soldernerd/LevelMeter/Levelmeter_RevB/Levelmeter.kicad_pcb

## KiCad design Levelmeter_RevB/Levelmeter.kicad_pcb (2026-08-13)

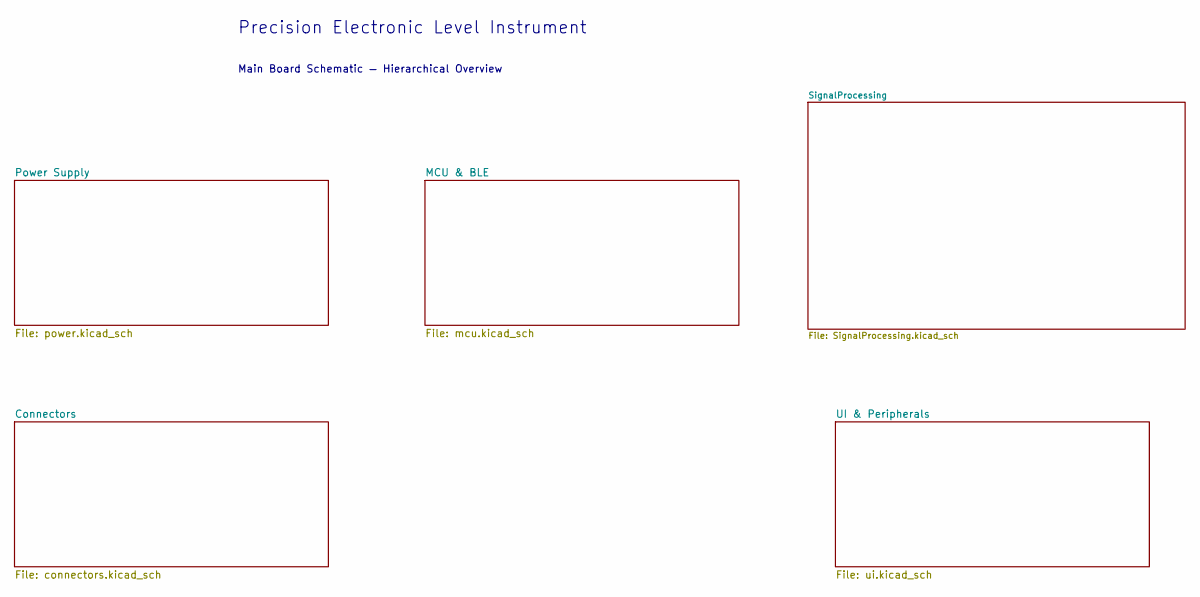
[picture p1: schematic Levelmeter.kicad_sch, Precision Electronic Level Instrument]

Notes on the sheet:
Main Board Schematic — Hierarchical Overview
Precision Electronic Level Instrument

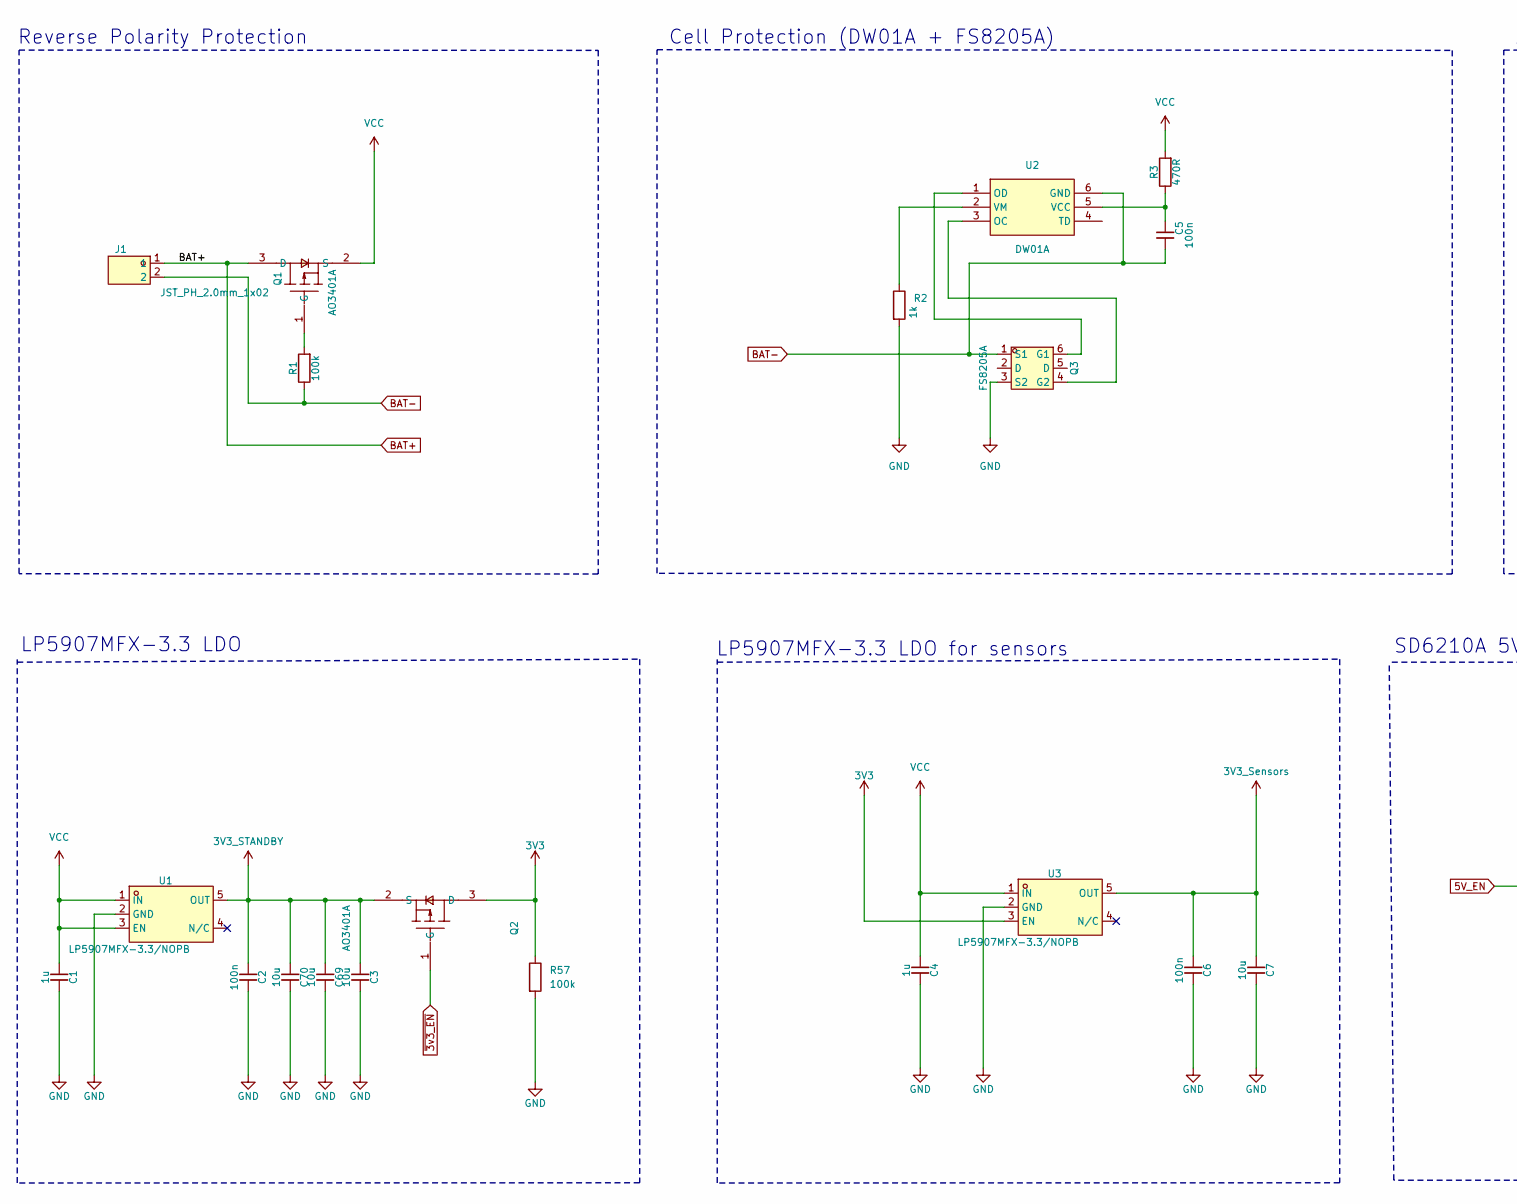
[picture p2: schematic power.kicad_sch, Power Supply, part in row 1, column 1]

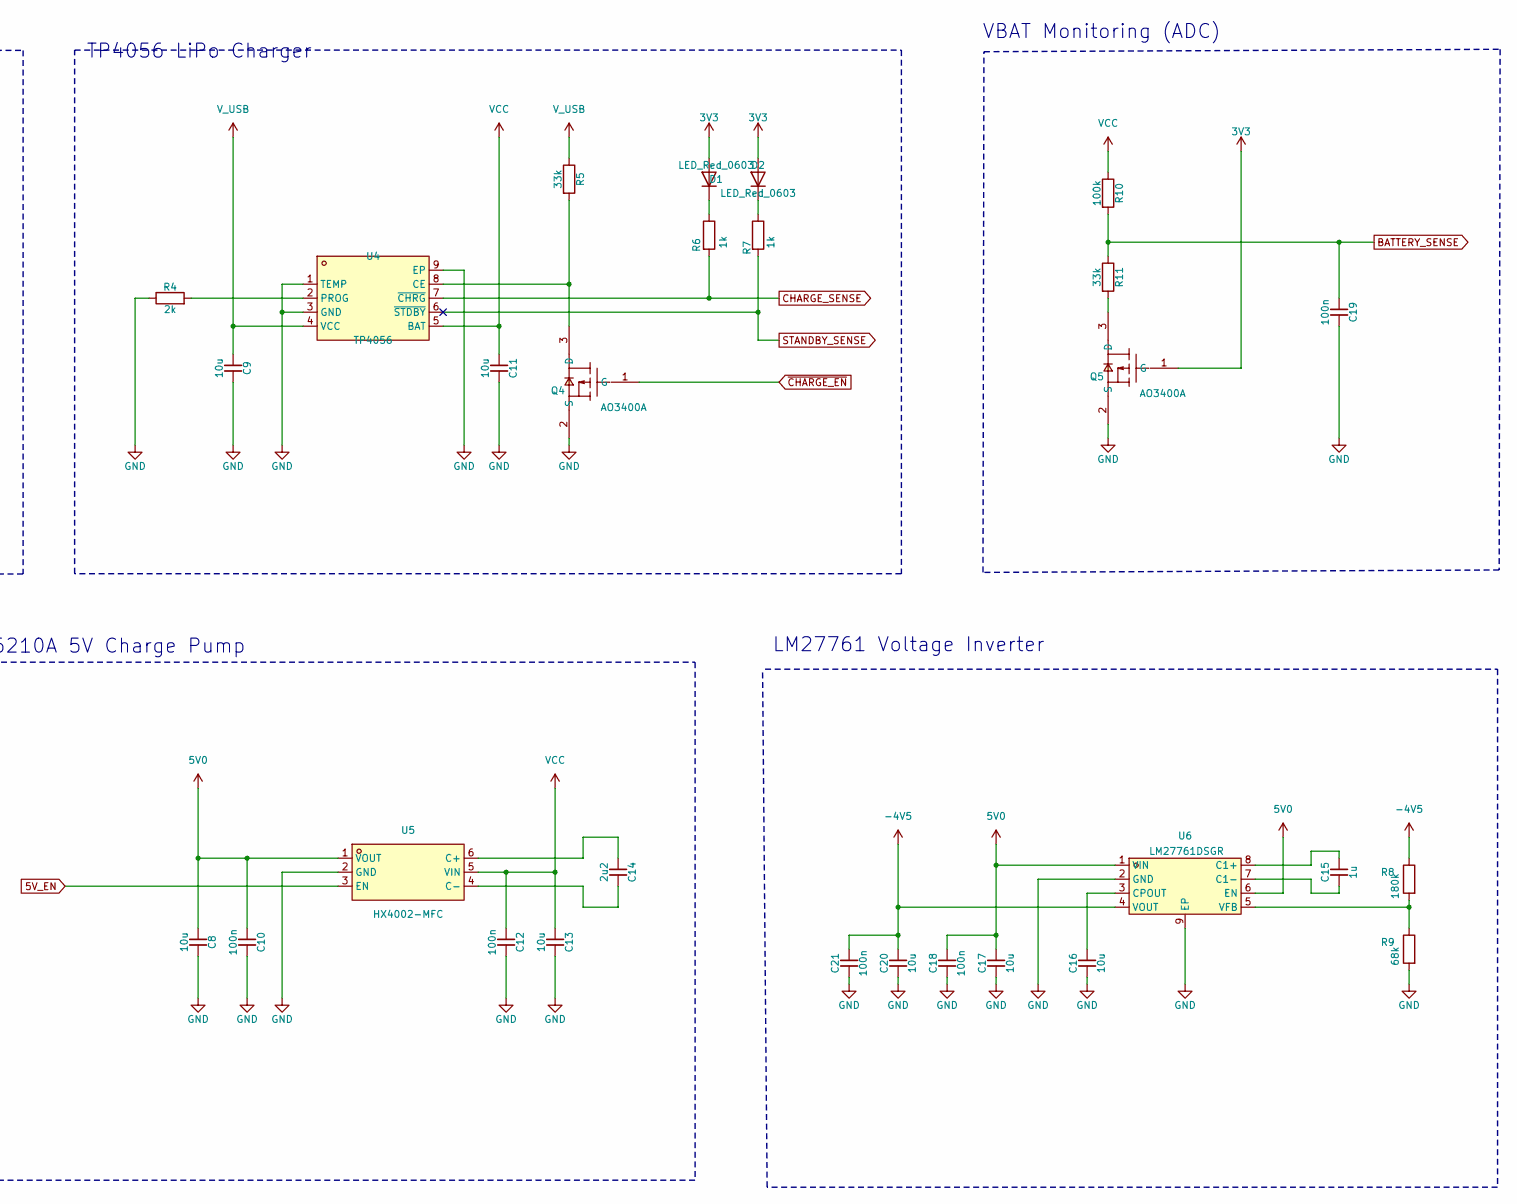
[picture p3: schematic power.kicad_sch, Power Supply, part in row 1, column 2]

Parts:
C1, C4, C15: 1u; C_0805; Voltage 50V; MPN CL21B105KBFNNNE; LCSC C28323
C2, C5, C6, C10, C12, C18, C19, C21: 100n; C_0603; Voltage 50V; MPN CC0603KRX7R9BB104; LCSC C14663
C3, C7, C8, C9, C11, C13, C16, C17, C20, C69, C70: 10u; C_0805; Voltage 50V; MPN GRM21BR61H106KE43L; LCSC C440198
C14: 2u2; C_0805; Voltage 50V; MPN CL21A225KBQNNNE; LCSC C377773
D1, D2: LED_Red_0603; LED_0603; MPN KT-0603R; LCSC C2286
J1: JST_PH_2.0mm_1x02; MPN B2B-PH-K-S; LCSC C131337
Q1, Q2: AO3401A; SOT-23-3; MPN AO3401A; LCSC C15127
Q3: FS8205A; SOT-23-6; MPN FS8205A; LCSC C2830320
Q4, Q5: AO3400A; SOT-23-3; MPN AO3400A; LCSC C20917
R1, R10, R57: 100k; R_0603; MPN 0603WAF1003T5E; LCSC C25803
R2, R6, R7: 1k; R_0603; MPN 0603WAF1001T5E; LCSC C21190
R3: 470R; R_0603; MPN 0603WAF4700T5E; LCSC C23179
R4: 2k; R_0603; MPN 0603WAF2001T5E; LCSC C22975
R5, R11: 33k; R_0603; MPN 0603WAF3302T5E; LCSC C4216
R8: 180k; R_0603; MPN 0603WAF1803T5E; LCSC C22827
R9: 68k; R_0603; MPN 0603WAF6802T5E; LCSC C23231
U1, U3: LP5907MFX-3.3/NOPB; SOT-23-5; MPN LP5907MFX-3.3/NOPB; LCSC C80670
U2: DW01A; SOT-23-6; MPN DW01A; LCSC C351410
U4: TP4056; ESOP-8; MPN TP4056; LCSC C382139
U5: HX4002-MFC; SOT-23-6; MPN HX4002-MFC; LCSC C172354
U6: LM27761DSGR; WSON-8-2x2-EP; MPN LM27761DSGR; LCSC C129351

Connections:
3V3: D1.2 (A), D2.2 (A), Q2.3 (D), Q5.1 (G), R57.1, U3.3 (EN); also elsewhere on the board
3V3_STANDBY: C2.1, C3.1, C69.1, C70.1, Q2.2 (S), U1.5 (OUT); also elsewhere on the board
3V3_Sensors: C6.1, C7.1, U3.5 (OUT); also elsewhere on the board
5V0: C8.1, C10.1, C17.1, C18.1, U5.1 (VOUT), U6.1 (VIN), U6.6 (EN); also elsewhere on the board
5V_EN: U5.3 (EN); also elsewhere on the board
~3v3_EN: Q2.1 (G); also elsewhere on the board
-4V5: C20.1, C21.1, R8.1, U6.4 (VOUT); also elsewhere on the board
BAT+: J1.1, Q1.3 (D)
BAT-: C5.2, J1.2, Q3.1 (S1), R1.1, U2.6 (GND)
BATTERY_SENSE: C19.1, R10.2, R11.1; also elsewhere on the board
CHARGE_SENSE: R6.2, U4.7 (~CHRG); also elsewhere on the board
GND: C1.2, C2.2, C3.2, C4.2, C6.2, C7.2, C8.2, C9.2, C10.2, C11.2, C12.2, C13.2, C16.2, C17.2, C18.2, C19.2, C20.2, C21.2, C69.2, C70.2, Q3.3 (S2), Q4.2 (S), Q5.2 (S), R2.2, R4.1, R9.2, R57.2, U1.2 (GND), U3.2 (GND), U4.1 (TEMP), U4.3 (GND), U4.9 (EP), U5.2 (GND), U6.2 (GND), U6.9 (EP); also elsewhere on the board
unnamed: D1.1 (K), R6.1
unnamed: D2.1 (K), R7.1
unnamed: Q1.1 (G), R1.2
unnamed: Q3.6 (G1), U2.1 (OD)
unnamed: Q3.4 (G2), U2.3 (OC)
unnamed: Q4.3 (D), R5.2, U4.8 (CE)
unnamed: Q5.3 (D), R11.2
unnamed: C5.1, R3.1, U2.5 (VCC)
unnamed: R2.1, U2.2 (VM)
unnamed: R4.2, U4.2 (PROG)
unnamed: C14.1, U5.6 (C+)
unnamed: C14.2, U5.4 (C-)
unnamed: C15.1, U6.8 (C1+)
unnamed: C15.2, U6.7 (C1-)
unnamed: C16.1, U6.3 (CPOUT)
unnamed: R8.2, R9.1, U6.5 (VFB)
STANDBY_SENSE: R7.2, U4.6 (~STDBY); also elsewhere on the board
VCC: C1.1, C4.1, C11.1, C12.1, C13.1, Q1.2 (S), R3.2, R10.1, U1.1 (IN), U1.3 (EN), U3.1 (IN), U4.5 (BAT), U5.5 (VIN)
V_USB: C9.1, R5.1, U4.4 (VCC); also elsewhere on the board
~CHARGE_EN: Q4.1 (G); also elsewhere on the board

Notes on the sheet:
LM27761 Voltage Inverter
LP5907MFX-3.3 LDO
VBAT Monitoring (ADC)
Cell Protection (DW01A + FS8205A)
TP4056 LiPo Charger
Reverse Polarity Protection
SD6210A 5V Charge Pump
LP5907MFX-3.3 LDO for sensors

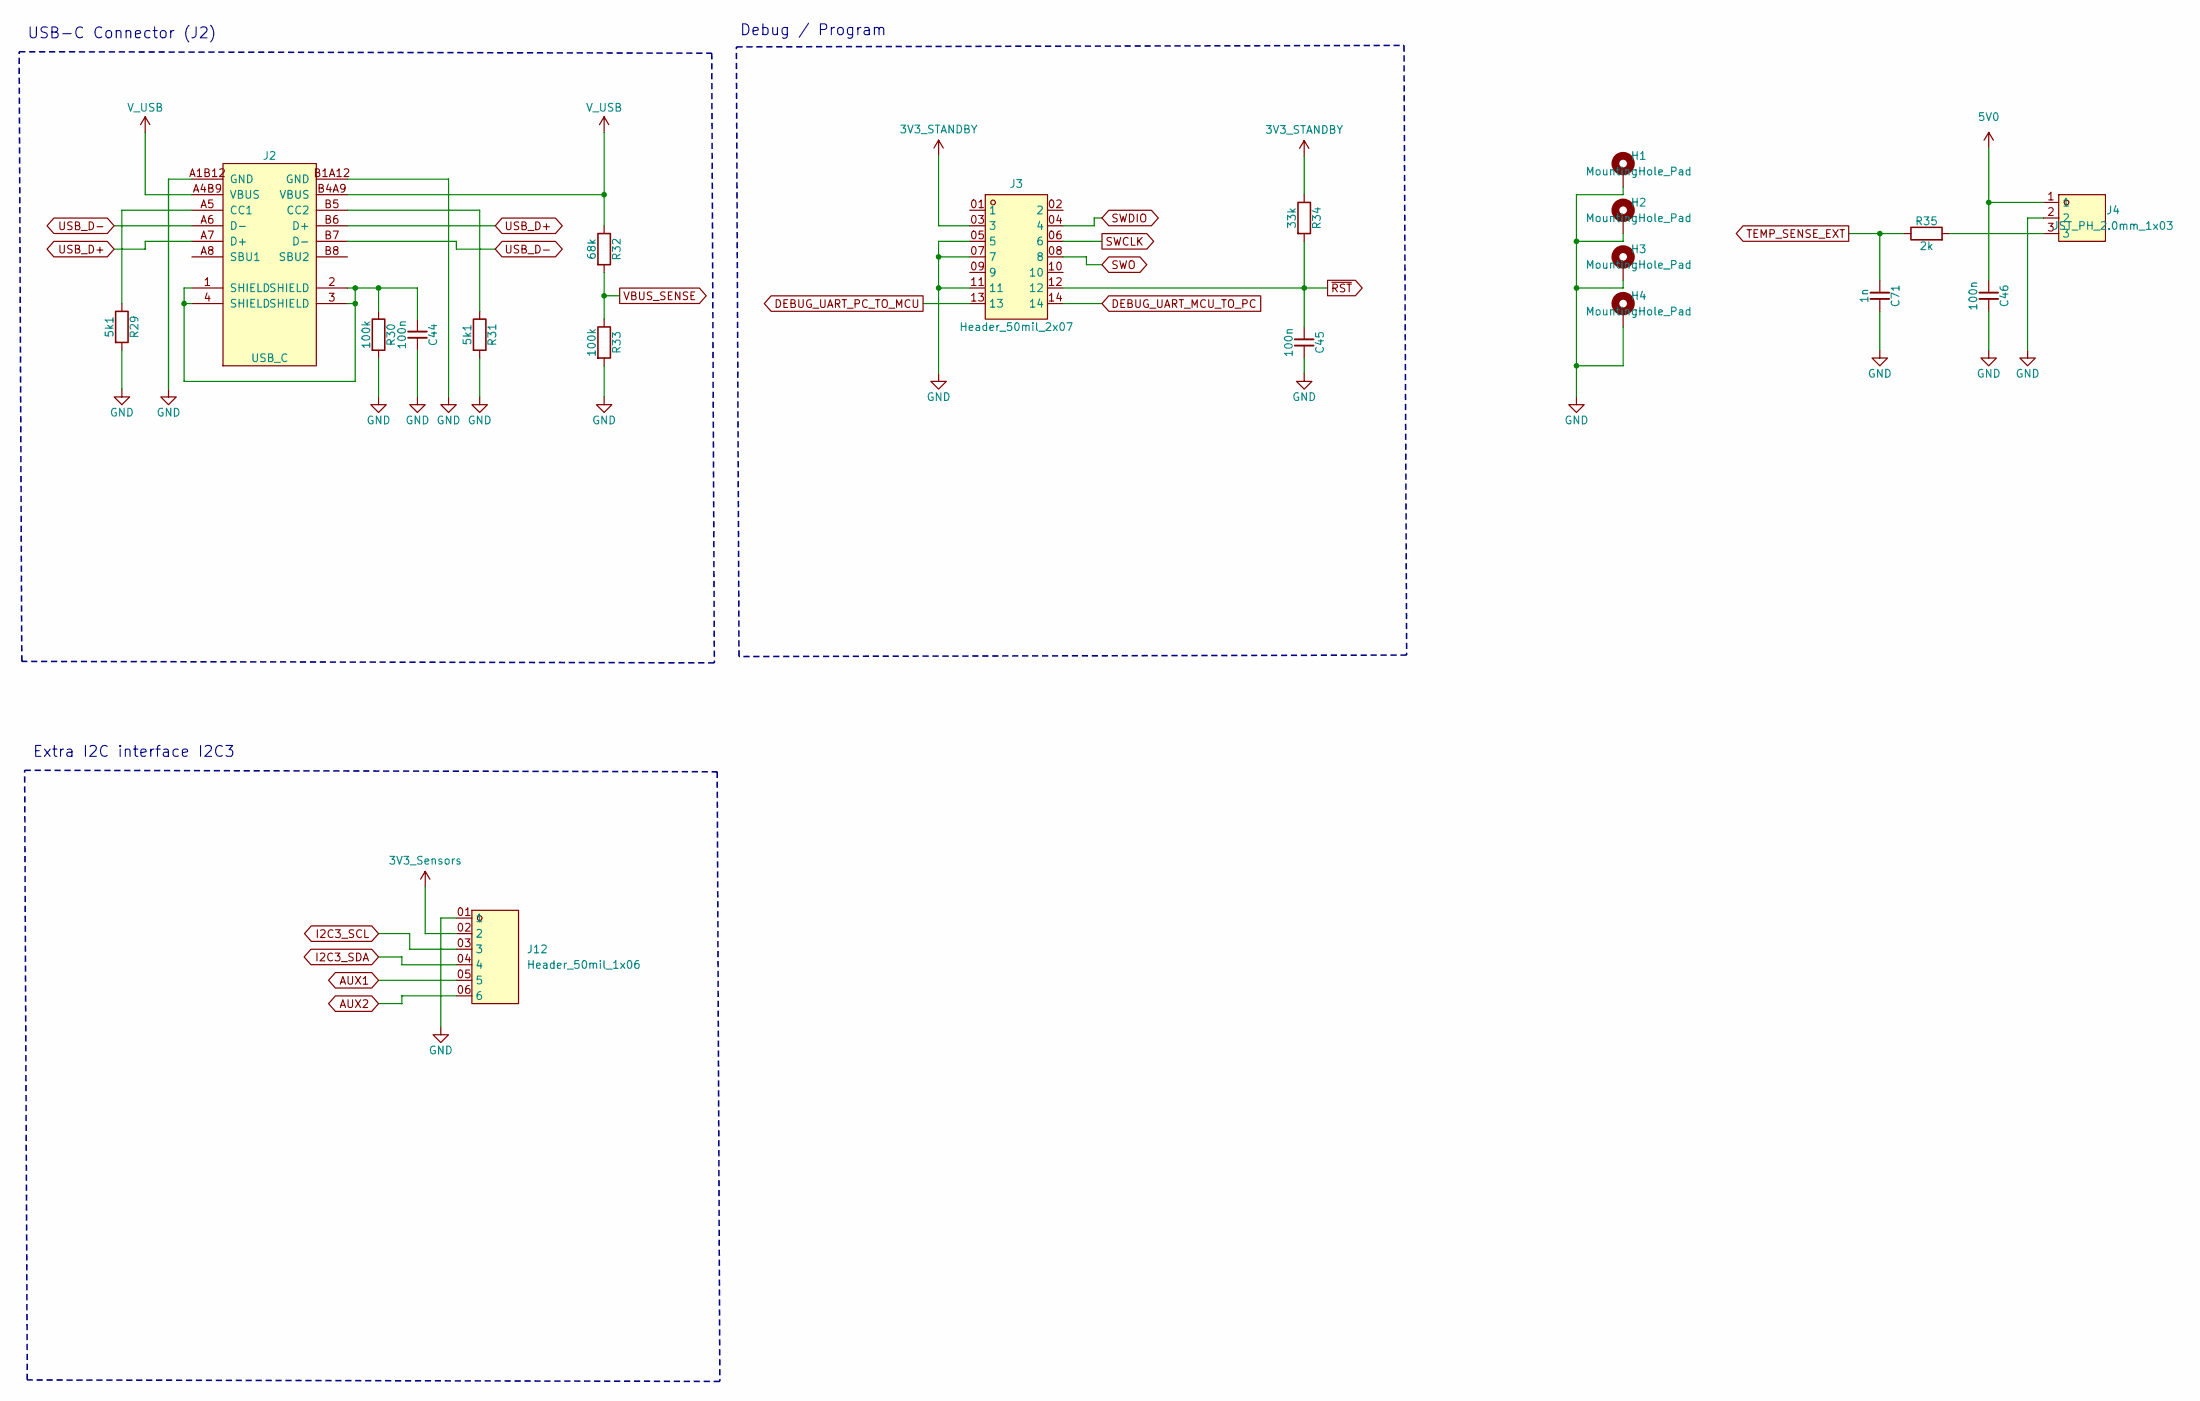
[picture p4: schematic connectors.kicad_sch]

Parts:
C44, C45, C46: 100n; C_0603; Voltage 50V; MPN CC0603KRX7R9BB104; LCSC C14663
C71: 1n; C_0603; Voltage 50V; MPN CL10B102KB8NNNC; LCSC C1588
H1, H2, H3, H4: MountingHole_Pad; MountingHole_3.2mm
J2: USB_C; MPN TYPE-C-31-M-12; LCSC C165948
J3: Header_50mil_2x07; LCSC C5563894
J4: JST_PH_2.0mm_1x03; MPN B3B-PH-K-S; LCSC C131339
J12: Header_50mil_1x06
R29, R31: 5k1; R_0603; MPN 0603WAF5101T5E; LCSC C23186
R30, R33: 100k; R_0603; MPN 0603WAF1003T5E; LCSC C25803
R32: 68k; R_0603; MPN 0603WAF6802T5E; LCSC C23231
R34: 33k; R_0603; MPN 0603WAF3302T5E; LCSC C4216
R35: 2k; R_0603; MPN 0603WAF2001T5E; LCSC C22975

Connections:
3V3_STANDBY: J3.03 (3), R34.1; also elsewhere on the board
3V3_Sensors: J12.02 (2); also elsewhere on the board
5V0: C46.1, J4.1; also elsewhere on the board
AUX1: J12.05 (5); also elsewhere on the board
AUX2: J12.06 (6); also elsewhere on the board
DEBUG_UART_MCU_TO_PC: J3.14; also elsewhere on the board
DEBUG_UART_PC_TO_MCU: J3.13; also elsewhere on the board
GND: C44.2, C45.2, C46.2, C71.2, H1.1 (1_1), H2.1 (1_1), H3.1 (1_1), H4.1 (1_1), J2.A1B12 (GND), J2.B1A12 (GND), J3.05 (5), J3.07 (7), J3.11, J4.2, J12.01 (1), R29.2, R30.2, R31.2, R33.2; also elsewhere on the board
I2C3_SCL: J12.03 (3); also elsewhere on the board
I2C3_SDA: J12.04 (4); also elsewhere on the board
unnamed: C44.1, J2.1 (SHIELD), J2.2 (SHIELD), J2.3 (SHIELD), J2.4 (SHIELD), R30.1
unnamed: J2.A5 (CC1), R29.1
unnamed: J2.B5 (CC2), R31.1
unnamed: J4.3, R35.2
SWCLK: J3.06 (6); also elsewhere on the board
SWDIO: J3.04 (4); also elsewhere on the board
SWO: J3.08 (8); also elsewhere on the board
TEMP_SENSE_EXT: C71.1, R35.1; also elsewhere on the board
USB_D+: J2.A7 (D+), J2.B6 (D+); also elsewhere on the board
USB_D-: J2.A6 (D-), J2.B7 (D-); also elsewhere on the board
VBUS_SENSE: R32.2, R33.1; also elsewhere on the board
V_USB: J2.A4B9 (VBUS), J2.B4A9 (VBUS), R32.1; also elsewhere on the board
~RST: C45.1, J3.12, R34.2; also elsewhere on the board

Notes on the sheet:
Extra I2C interface I2C3
USB-C Connector (J2)
Debug / Program

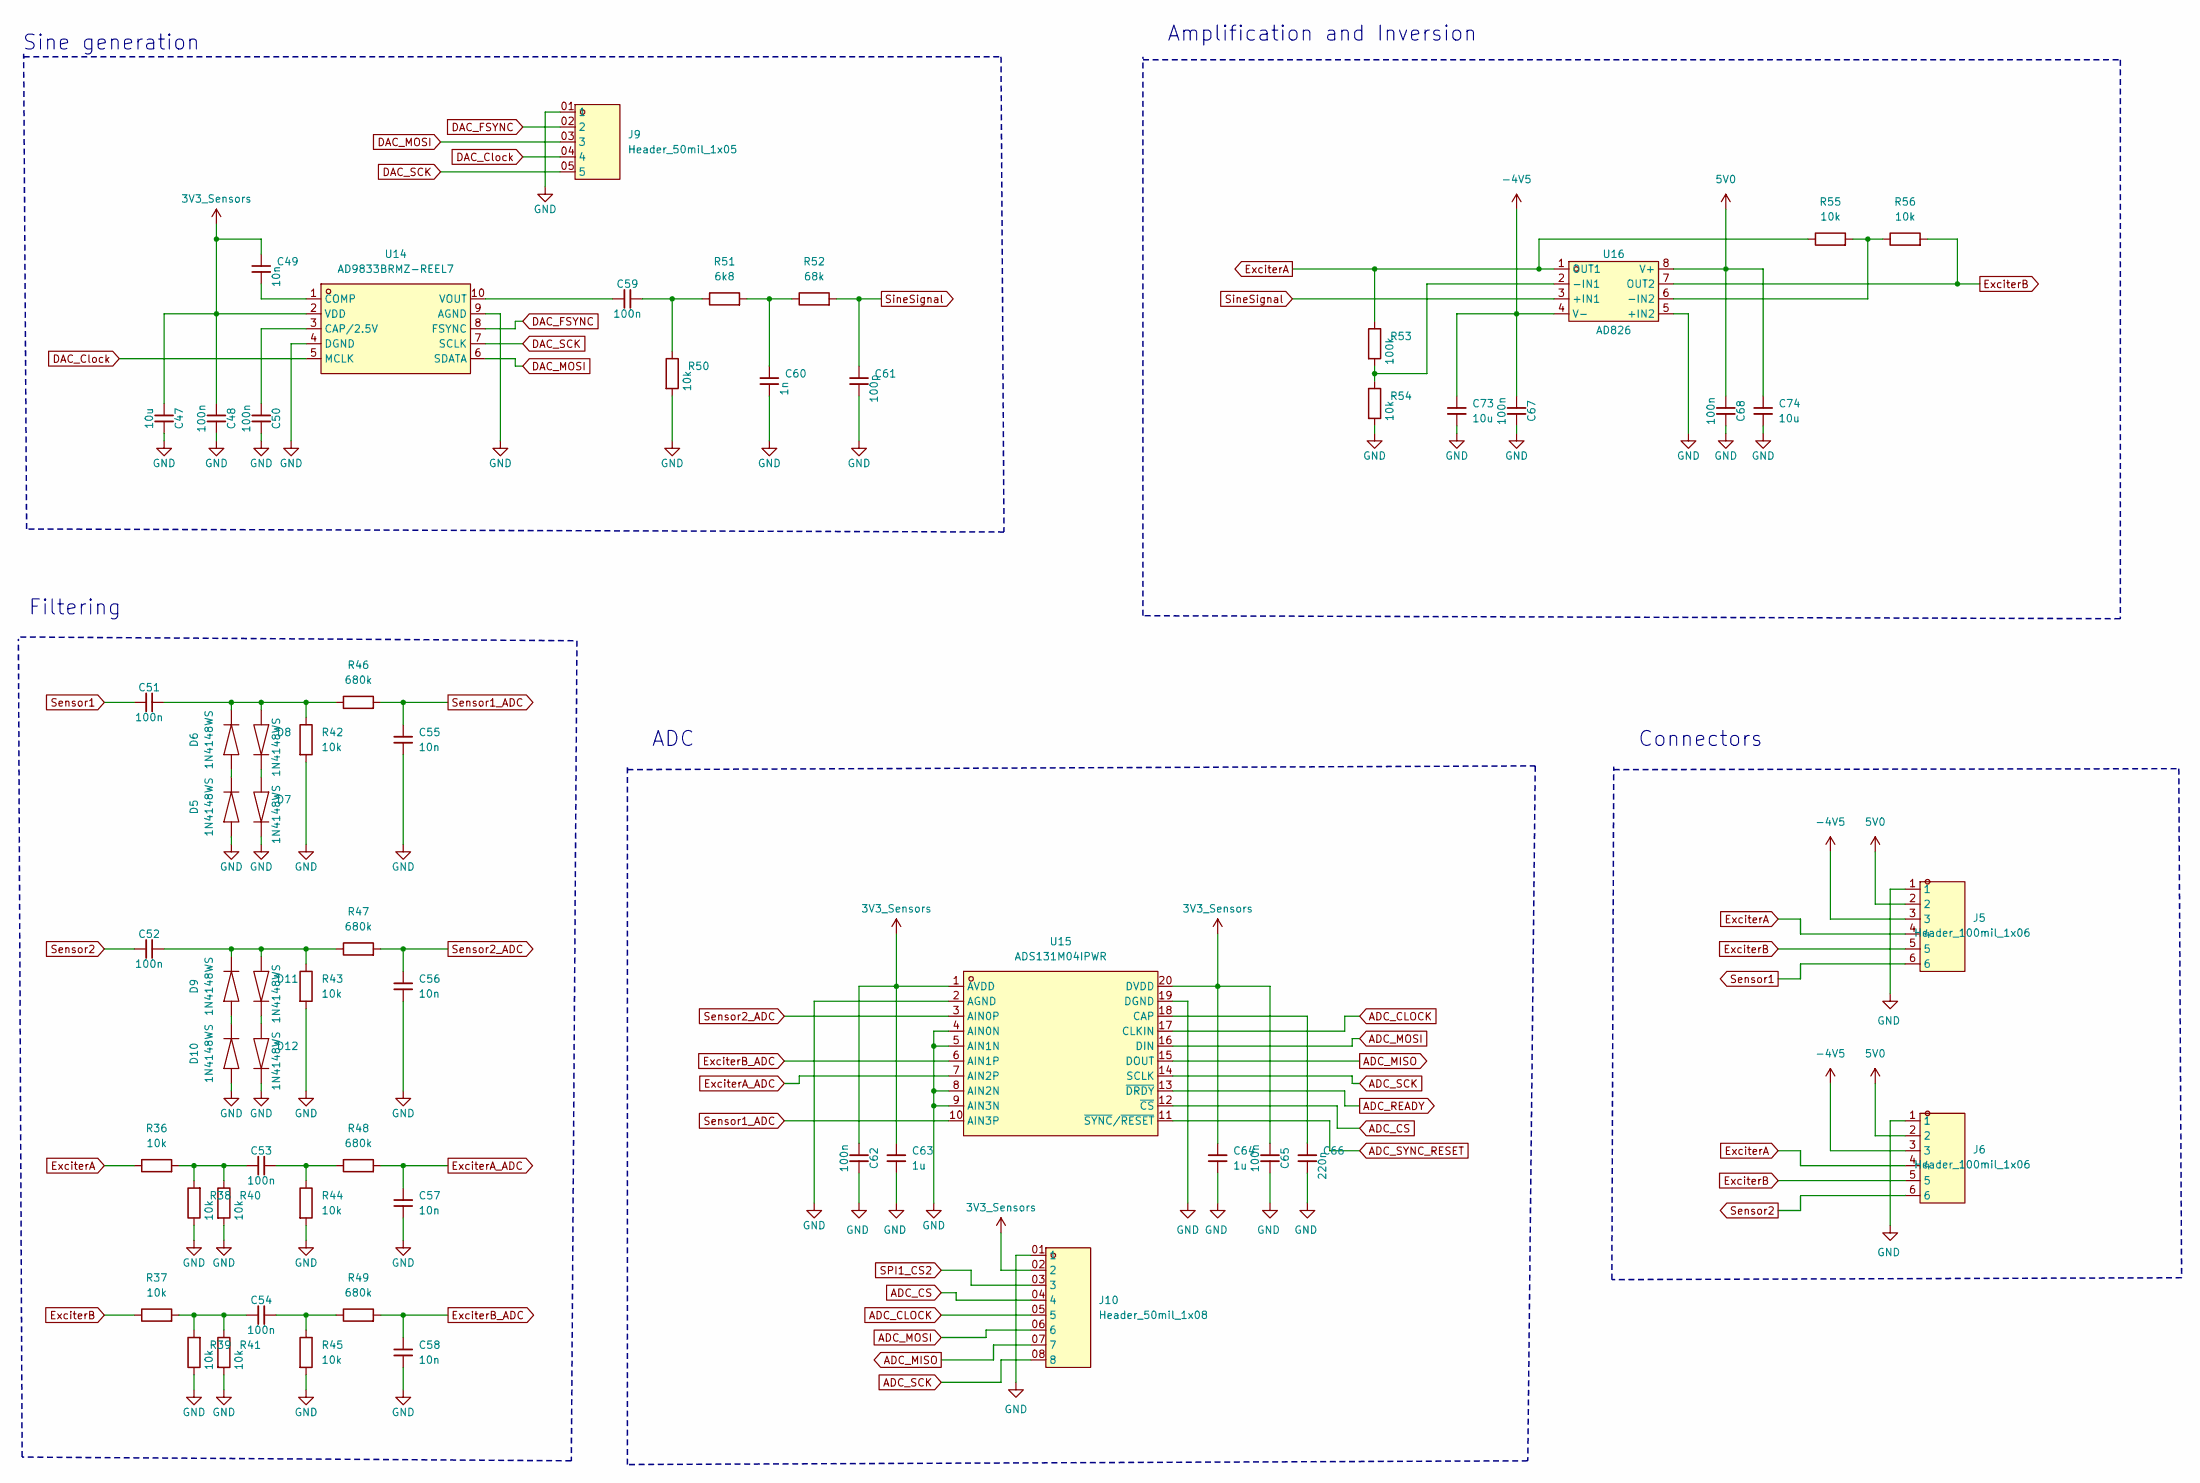
[picture p5: schematic SignalProcessing.kicad_sch]

Parts:
C47, C73, C74: 10u; C_0805; Voltage 50V; MPN GRM21BR61H106KE43L; LCSC C440198
C48, C50, C51, C52, C53, C54, C59, C62, C65, C67, C68: 100n; C_0603; Voltage 50V; MPN CC0603KRX7R9BB104; LCSC C14663
C49, C55, C56, C57, C58: 10n; C_0603; Voltage 50V; MPN 0603B103K500NT; LCSC C57112
C60: 1n; C_0603; Voltage 50V; MPN CL10B102KB8NNNC; LCSC C1588
C61: 100p; C_0603; Voltage 50V; MPN CL10C101JB8NNNC; LCSC C14858
C63, C64: 1u; C_0805; Voltage 50V; MPN CL21B105KBFNNNE; LCSC C28323
C66: 220n; C_0603; Voltage 25V; MPN CL10B224KA8NNNC; LCSC C21120
D5, D6, D7, D8, D9, D10, D11, D12: 1N4148WS; SOD-323; MPN 1N4148WS; LCSC C2128
J5, J6: Header_100mil_1x06; MPN A2541WV-6P; LCSC C225481
J9: Header_50mil_1x05
J10: Header_50mil_1x08
R36, R37, R38, R39, R40, R41, R42, R43, R44, R45, R50, R55, R56: 10k; R_0603; MPN 0603WAF1002T5E; LCSC C25804
R46, R47, R48, R49: 680k; R_0603; MPN 0603WAF6803T5E; LCSC C25822
R51: 6k8; R_0603; MPN 0603WAF6801T5E; LCSC C23212
R52: 68k; R_0603; MPN 0603WAF6802T5E; LCSC C23231
R53: 100k; R_0805; MPN 0805W8F1003T5E; LCSC C149504
R54: 10k; R_0805; MPN 0805W8F1002T5E; LCSC C17414
U14: AD9833BRMZ-REEL7; MSOP-10; MPN AD9833BRMZ-REEL7; LCSC C9652
U15: ADS131M04IPWR; TSSOP-20; MPN ADS131M04IPWR; LCSC C2862562
U16: AD826; SOIC-8; MPN AD826ARZ-REEL7; LCSC C114171

Connections:
3V3_Sensors: C47.1, C48.1, C49.1, C62.1, C63.1, C64.1, C65.1, J10.02 (2), U14.2 (VDD), U15.1 (AVDD), U15.20 (DVDD); also elsewhere on the board
5V0: C68.1, C74.1, J5.2, J6.2, U16.8 (V+); also elsewhere on the board
-4V5: C67.1, C73.1, J5.3, J6.3, U16.4 (V-); also elsewhere on the board
ADC_CLOCK: J10.05 (5), U15.17 (CLKIN); also elsewhere on the board
ADC_CS: J10.04 (4), U15.12 (~CS); also elsewhere on the board
ADC_MISO: J10.07 (7), U15.15 (DOUT); also elsewhere on the board
ADC_MOSI: J10.06 (6), U15.16 (DIN); also elsewhere on the board
ADC_READY: U15.13 (~DRDY); also elsewhere on the board
ADC_SCK: J10.08 (8), U15.14 (SCLK); also elsewhere on the board
ADC_SYNC_RESET: U15.11 (~SYNC/~RESET); also elsewhere on the board
DAC_Clock: J9.04 (4), U14.5 (MCLK); also elsewhere on the board
DAC_FSYNC: J9.02 (2), U14.8 (FSYNC); also elsewhere on the board
DAC_MOSI: J9.03 (3), U14.6 (SDATA); also elsewhere on the board
DAC_SCK: J9.05 (5), U14.7 (SCLK); also elsewhere on the board
ExciterA: J5.4, J6.4, R36.1, R53.1, R55.1, U16.1 (OUT1)
ExciterA_ADC: C57.1, R48.2, U15.7 (AIN2P)
ExciterB: J5.5, J6.5, R37.1, R56.2, U16.7 (OUT2)
ExciterB_ADC: C58.1, R49.2, U15.6 (AIN1P)
GND: C47.2, C48.2, C50.2, C55.2, C56.2, C57.2, C58.2, C60.2, C61.2, C62.2, C63.2, C64.2, C65.2, C66.2, C67.2, C68.2, C73.2, C74.2, D5.2 (A), D7.1 (K), D10.2 (A), D12.1 (K), J5.1, J6.1, J9.01 (1), J10.01 (1), R38.1, R39.1, R40.2, R41.2, R42.2, R43.2, R44.2, R45.2, R50.2, R54.2, U14.4 (DGND), U14.9 (AGND), U15.2 (AGND), U15.4 (AIN0N), U15.5 (AIN1N), U15.8 (AIN2N), U15.9 (AIN3N), U15.19 (DGND), U16.5 (+IN2); also elsewhere on the board
unnamed: C53.1, R36.2, R38.2, R40.1
unnamed: C53.2, R44.1, R48.1
unnamed: C54.1, R37.2, R39.2, R41.1
unnamed: C54.2, R45.1, R49.1
unnamed: C59.2, R50.1, R51.1
unnamed: C60.1, R51.2, R52.1
unnamed: D5.1 (K), D6.2 (A)
unnamed: C51.2, D6.1 (K), D8.2 (A), R42.1, R46.1
unnamed: D7.2 (A), D8.1 (K)
unnamed: D9.2 (A), D10.1 (K)
unnamed: C52.2, D9.1 (K), D11.2 (A), R43.1, R47.1
unnamed: D11.1 (K), D12.2 (A)
unnamed: C50.1, U14.3 (CAP/2.5V)
unnamed: C49.2, U14.1 (COMP)
unnamed: C59.1, U14.10 (VOUT)
unnamed: C66.1, U15.18 (CAP)
unnamed: R53.2, R54.1, U16.2 (-IN1)
unnamed: R55.2, R56.1, U16.6 (-IN2)
SPI1_CS2: J10.03 (3); also elsewhere on the board
Sensor1: C51.1, J5.6
Sensor1_ADC: C55.1, R46.2, U15.10 (AIN3P)
Sensor2: C52.1, J6.6
Sensor2_ADC: C56.1, R47.2, U15.3 (AIN0P)
SineSignal: C61.1, R52.2, U16.3 (+IN1)

Notes on the sheet:
ADC
Connectors
Filtering
Amplification and Inversion
Sine generation

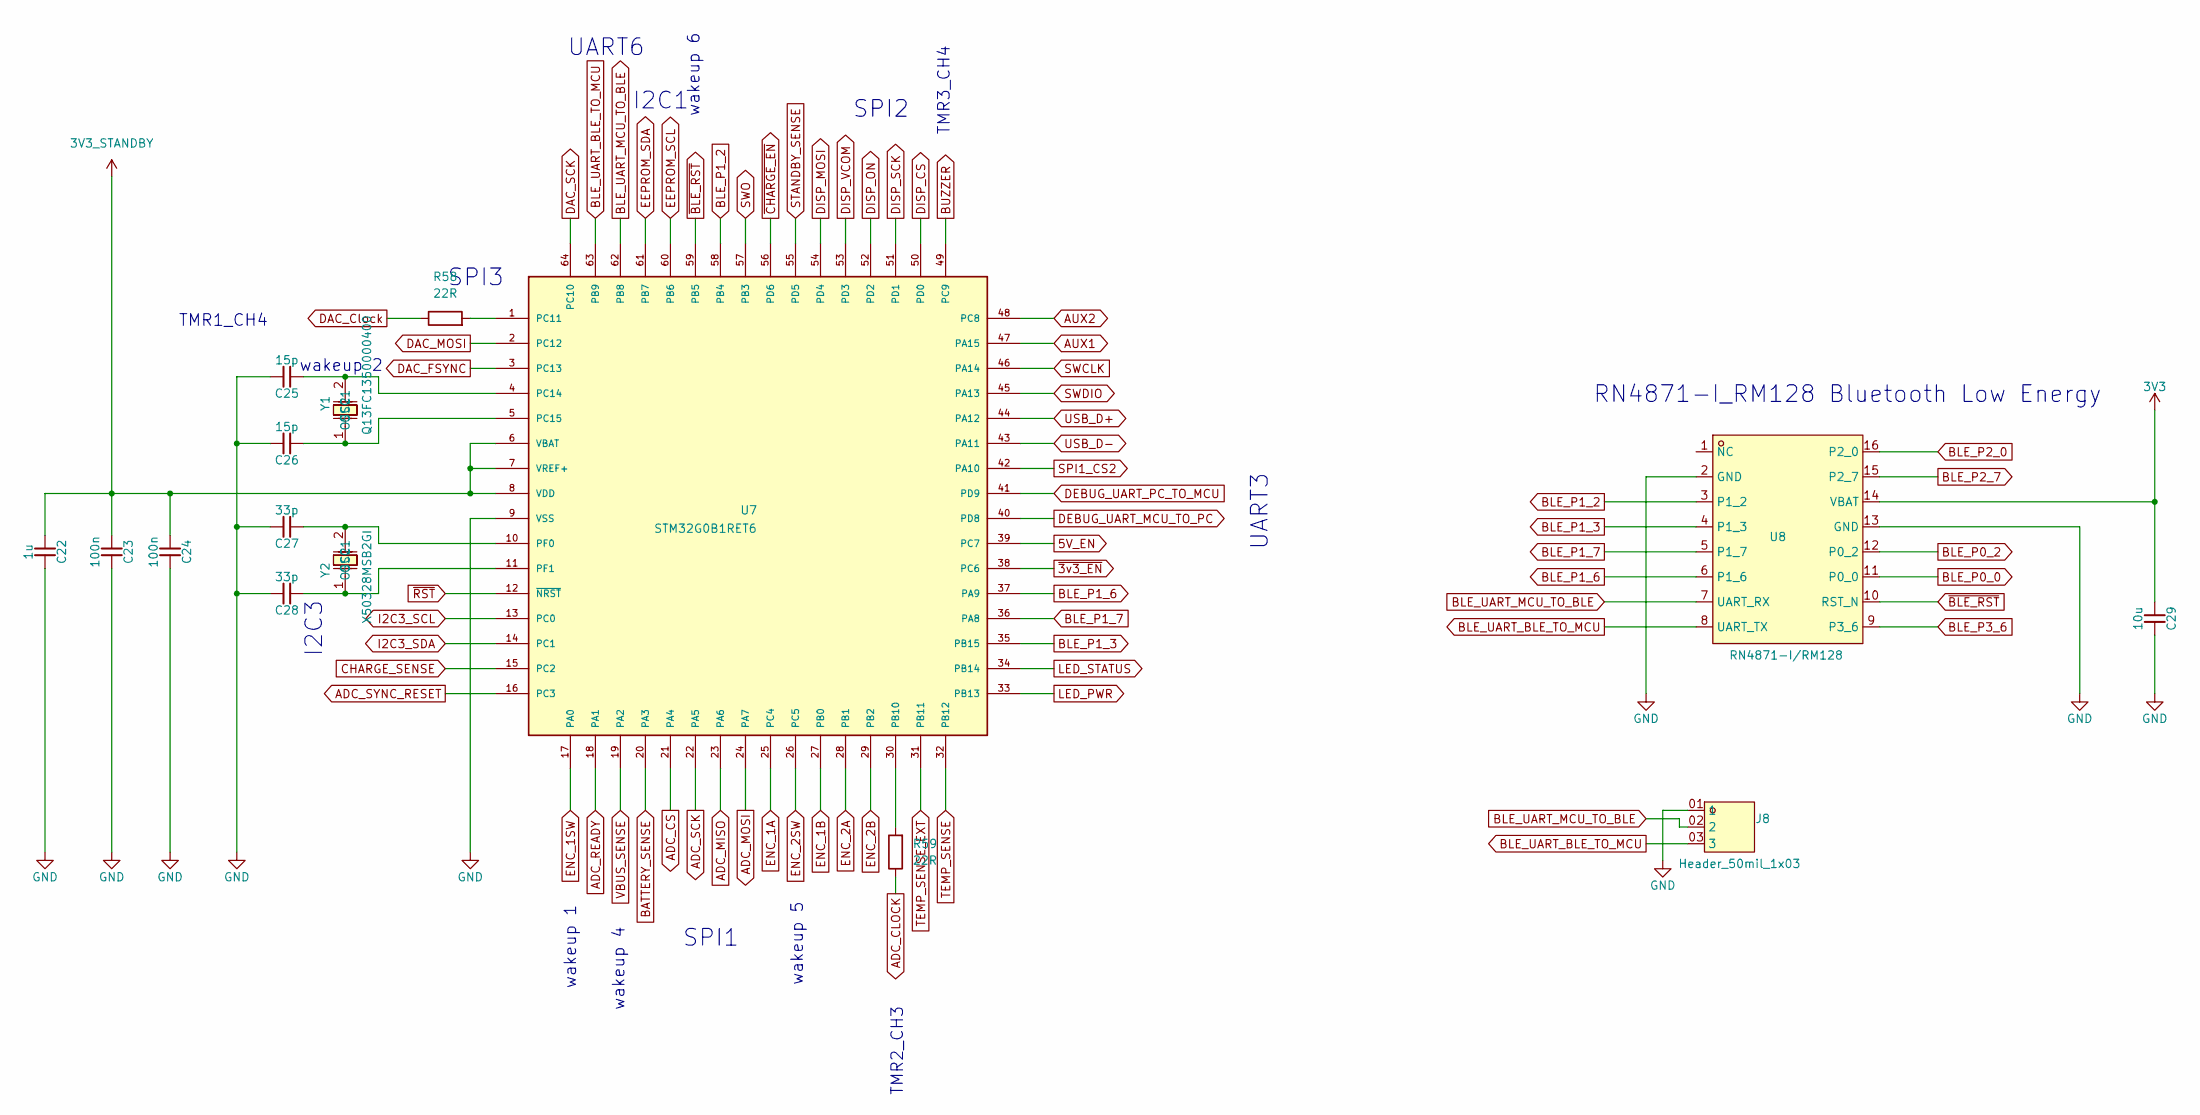
[picture p6: schematic mcu.kicad_sch, Microcontroller — STM32G0B1RET6]

Parts:
C22: 1u; C_0805; Voltage 50V; MPN CL21B105KBFNNNE; LCSC C28323
C23, C24: 100n; C_0603; Voltage 50V; MPN CC0603KRX7R9BB104; LCSC C14663
C25, C26: 15p; C_0603; Voltage 50V; MPN CL10C150JB8NNNC; LCSC C1644
C27, C28: 33p; C_0603; Voltage 50V; MPN CL10C330JB8NNNC; LCSC C1663
C29: 10u; C_0805; Voltage 50V; MPN GRM21BR61H106KE43L; LCSC C440198
J8: Header_50mil_1x03; MPN HC-PZ127-7.2L-1x3PZ; LCSC C42162998
R58, R59: 22R; R_0603; MPN 0603WAF220JT5E; LCSC C23345
U7: STM32G0B1RET6; LQFP-64; LCSC C2829307
U8: RN4871-I/RM128; RN4871; MPN RN4871-I/RM128; LCSC C633941
Y1: Q13FC1350000400; CRYSTAL-3215; MPN Q13FC1350000400; LCSC C32346
Y2: X50328MSB2GI; CRYSTAL-3225; MPN X50328MSB2GI; LCSC C115962

Connections:
3V3: C29.1, U8.14 (VBAT); also elsewhere on the board
3V3_STANDBY: C22.1, C23.1, C24.1, U7.6 (VBAT), U7.7 (VREF+), U7.8 (VDD); also elsewhere on the board
5V_EN: U7.39 (PC7); also elsewhere on the board
~3v3_EN: U7.38 (PC6); also elsewhere on the board
ADC_CLOCK: R59.1; also elsewhere on the board
ADC_CS: U7.21 (PA4); also elsewhere on the board
ADC_MISO: U7.23 (PA6); also elsewhere on the board
ADC_MOSI: U7.24 (PA7); also elsewhere on the board
ADC_READY: U7.18 (PA1); also elsewhere on the board
ADC_SCK: U7.22 (PA5); also elsewhere on the board
ADC_SYNC_RESET: U7.16 (PC3); also elsewhere on the board
AUX1: U7.47 (PA15); also elsewhere on the board
AUX2: U7.48 (PC8); also elsewhere on the board
BATTERY_SENSE: U7.20 (PA3); also elsewhere on the board
BLE_P0_0: U8.11 (P0_0)
BLE_P0_2: U8.12 (P0_2)
BLE_P1_2: U7.58 (PB4), U8.3 (P1_2)
BLE_P1_3: U7.35 (PB15), U8.4 (P1_3)
BLE_P1_6: U7.37 (PA9), U8.6 (P1_6)
BLE_P1_7: U7.36 (PA8), U8.5 (P1_7)
BLE_P2_0: U8.16 (P2_0)
BLE_P2_7: U8.15 (P2_7)
BLE_P3_6: U8.9 (P3_6)
BLE_UART_BLE_TO_MCU: J8.03 (3), U7.63 (PB9), U8.8 (UART_TX)
BLE_UART_MCU_TO_BLE: J8.02 (2), U7.62 (PB8), U8.7 (UART_RX)
BUZZER: U7.49 (PC9); also elsewhere on the board
CHARGE_SENSE: U7.15 (PC2); also elsewhere on the board
DAC_Clock: R58.1; also elsewhere on the board
DAC_FSYNC: U7.3 (PC13); also elsewhere on the board
DAC_MOSI: U7.2 (PC12); also elsewhere on the board
DAC_SCK: U7.64 (PC10); also elsewhere on the board
DEBUG_UART_MCU_TO_PC: U7.40 (PD8); also elsewhere on the board
DEBUG_UART_PC_TO_MCU: U7.41 (PD9); also elsewhere on the board
DISP_CS: U7.50 (PD0); also elsewhere on the board
DISP_MOSI: U7.54 (PD4); also elsewhere on the board
DISP_ON: U7.52 (PD2); also elsewhere on the board
DISP_SCK: U7.51 (PD1); also elsewhere on the board
DISP_VCOM: U7.53 (PD3); also elsewhere on the board
EEPROM_SCL: U7.60 (PB6); also elsewhere on the board
EEPROM_SDA: U7.61 (PB7); also elsewhere on the board
ENC_1A: U7.25 (PC4); also elsewhere on the board
ENC_1B: U7.27 (PB0); also elsewhere on the board
ENC_1SW: U7.17 (PA0); also elsewhere on the board
ENC_2A: U7.28 (PB1); also elsewhere on the board
ENC_2B: U7.29 (PB2); also elsewhere on the board
ENC_2SW: U7.26 (PC5); also elsewhere on the board
GND: C22.2, C23.2, C24.2, C25.2, C26.2, C27.2, C28.2, C29.2, J8.01 (1), U7.9 (VSS), U8.2 (GND), U8.13 (GND); also elsewhere on the board
I2C3_SCL: U7.13 (PC0); also elsewhere on the board
I2C3_SDA: U7.14 (PC1); also elsewhere on the board
LED_PWR: U7.33 (PB13); also elsewhere on the board
LED_STATUS: U7.34 (PB14); also elsewhere on the board
unnamed: R59.2, U7.30 (PB10)
unnamed: R58.2, U7.1 (PC11)
unnamed: C25.1, U7.4 (PC14), Y1.2 (OSC2)
unnamed: C26.1, U7.5 (PC15), Y1.1 (OSC1)
unnamed: C27.1, U7.10 (PF0), Y2.2 (OSC2)
unnamed: C28.1, U7.11 (PF1), Y2.1 (OSC1)
SPI1_CS2: U7.42 (PA10); also elsewhere on the board
STANDBY_SENSE: U7.55 (PD5); also elsewhere on the board
SWCLK: U7.46 (PA14); also elsewhere on the board
SWDIO: U7.45 (PA13); also elsewhere on the board
SWO: U7.57 (PB3); also elsewhere on the board
TEMP_SENSE: U7.32 (PB12); also elsewhere on the board
TEMP_SENSE_EXT: U7.31 (PB11); also elsewhere on the board
USB_D+: U7.44 (PA12); also elsewhere on the board
USB_D-: U7.43 (PA11); also elsewhere on the board
VBUS_SENSE: U7.19 (PA2); also elsewhere on the board
~BLE_RST: U7.59 (PB5), U8.10 (RST_N)
~CHARGE_EN: U7.56 (PD6); also elsewhere on the board
~RST: U7.12 (~NRST); also elsewhere on the board

Notes on the sheet:
SPI1
TMR2_CH3
wakeup 2
wakeup 1
TMR3_CH4
TMR1_CH4
SPI2
wakeup 5
I2C3
wakeup 4
I2C1
UART6
wakeup 6
RN4871-I_RM128 Bluetooth Low Energy
UART3
SPI3
