soldernerd/LevelMeter/Levelmeter_RevB/Levelmeter.kicad_pcb

## KiCad design Levelmeter_RevB/Levelmeter.kicad_pcb (continued)

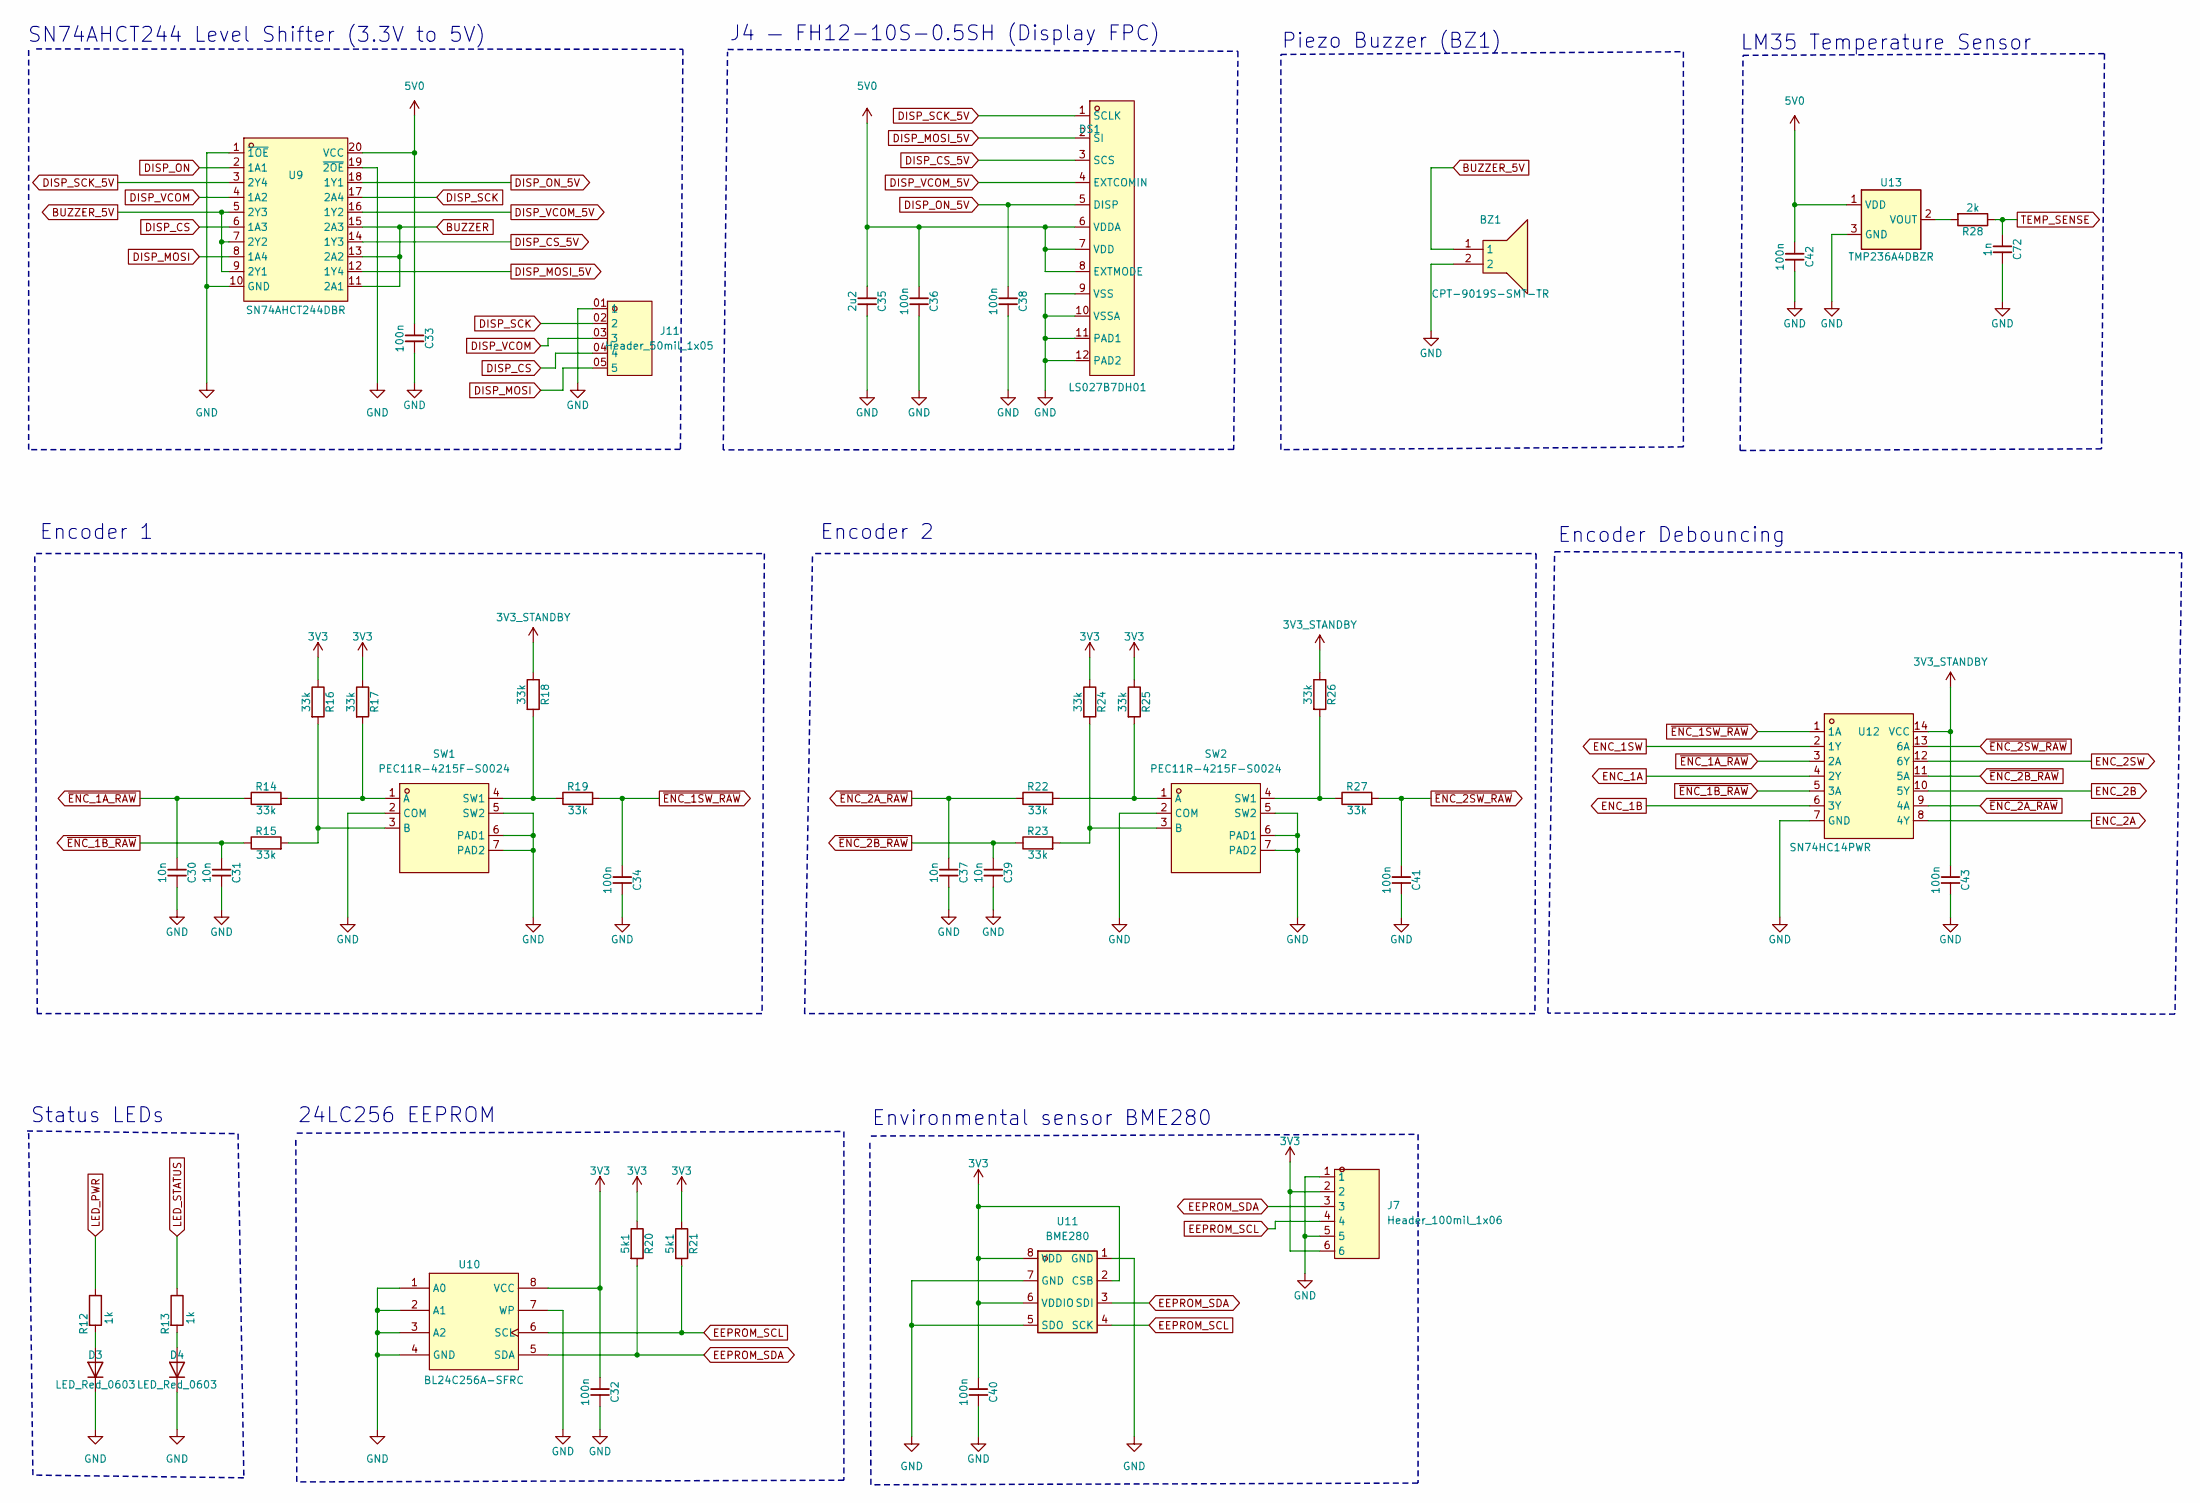
[picture p7: schematic ui.kicad_sch, User Interface & Peripherals]

Parts:
BZ1: CPT-9019S-SMT-TR; CPT-9019S; MPN CPT-9019S-SMT-TR; LCSC C95163
C30, C31, C37, C39: 10n; C_0603; Voltage 50V; MPN 0603B103K500NT; LCSC C57112
C32, C33, C34, C36, C38, C40, C41, C42, C43: 100n; C_0603; Voltage 50V; MPN CC0603KRX7R9BB104; LCSC C14663
C35: 2u2; C_0805; Voltage 50V; MPN CL21A225KBQNNNE; LCSC C377773
C72: 1n; C_0603; Voltage 50V; MPN CL10B102KB8NNNC; LCSC C1588
D3, D4: LED_Red_0603; LED_0603; MPN KT-0603R; LCSC C2286
DS1: LS027B7DH01; Display_LS027B7DH01; MPN LS027B7DH01; LCSC Display: C17492463, Connector: C262557
J7: Header_100mil_1x06; MPN A2541WV-6P; LCSC C225481
J11: Header_50mil_1x05
R12, R13: 1k; R_0603; MPN 0603WAF1001T5E; LCSC C21190
R14, R15, R16, R17, R18, R19, R22, R23, R24, R25, R26, R27: 33k; R_0603; MPN 0603WAF3302T5E; LCSC C4216
R20, R21: 5k1; R_0603; MPN 0603WAF5101T5E; LCSC C23186
R28: 2k; R_0603; MPN 0603WAF2001T5E; LCSC C22975
SW1, SW2: PEC11R-4215F-S0024; RotaryEncoder_PEC11R; MPN PEC11R-4215F-S0024; LCSC C143790
U9: SN74AHCT244DBR; SSOP-20; MPN SN74AHCT244DBR; LCSC C2868870
U10: BL24C256A-SFRC; TSSOP-8; MPN BL24C256A-SFRC; LCSC C110276
U11: BME280; LGA-8_2.5x2.5mm_P0.65mm; MPN BME280; LCSC C92489
U12: SN74HC14PWR; TSSOP-14; MPN SN74HC14PWR; LCSC C6821
U13: TMP236A4DBZR; SOT-23-3; MPN TMP236A4DBZR; LCSC C2872164

Connections:
3V3: C32.1, C40.1, J7.2, J7.6, R16.1, R17.1, R20.1, R21.1, R24.1, R25.1, U10.8 (VCC), U11.2 (CSB), U11.6 (VDDIO), U11.8 (VDD); also elsewhere on the board
3V3_STANDBY: C43.1, R18.1, R26.1, U12.14 (VCC); also elsewhere on the board
5V0: C33.1, C35.1, C36.1, C42.1, DS1.6 (VDDA), DS1.7 (VDD), DS1.8 (EXTMODE), U9.20 (VCC), U13.1 (VDD); also elsewhere on the board
BUZZER: U9.11 (2A1), U9.13 (2A2), U9.15 (2A3); also elsewhere on the board
BUZZER_5V: BZ1.1, U9.5 (2Y3), U9.7 (2Y2), U9.9 (2Y1)
DISP_CS: J11.04 (4), U9.6 (1A3); also elsewhere on the board
DISP_CS_5V: DS1.3 (SCS), U9.14 (1Y3)
DISP_MOSI: J11.05 (5), U9.8 (1A4); also elsewhere on the board
DISP_MOSI_5V: DS1.2 (SI), U9.12 (1Y4)
DISP_ON: U9.2 (1A1); also elsewhere on the board
DISP_ON_5V: C38.1, DS1.5 (DISP), U9.18 (1Y1)
DISP_SCK: J11.02 (2), U9.17 (2A4); also elsewhere on the board
DISP_SCK_5V: DS1.1 (SCLK), U9.3 (2Y4)
DISP_VCOM: J11.03 (3), U9.4 (1A2); also elsewhere on the board
DISP_VCOM_5V: DS1.4 (EXTCOMIN), U9.16 (1Y2)
EEPROM_SCL: J7.4, R21.2, U10.6 (SCL), U11.4 (SCK); also elsewhere on the board
EEPROM_SDA: J7.3, R20.2, U10.5 (SDA), U11.3 (SDI); also elsewhere on the board
ENC_1A: U12.4 (2Y); also elsewhere on the board
ENC_1B: U12.6 (3Y); also elsewhere on the board
ENC_1SW: U12.2 (1Y); also elsewhere on the board
ENC_2A: U12.8 (4Y); also elsewhere on the board
ENC_2B: U12.10 (5Y); also elsewhere on the board
ENC_2SW: U12.12 (6Y); also elsewhere on the board
GND: BZ1.2, C30.2, C31.2, C32.2, C33.2, C34.2, C35.2, C36.2, C37.2, C38.2, C39.2, C40.2, C41.2, C42.2, C43.2, C72.2, D3.1 (K), D4.1 (K), DS1.9 (VSS), DS1.10 (VSSA), DS1.11 (PAD1), DS1.12 (PAD2), J7.1, J7.5, J11.01 (1), SW1.2 (COM), SW1.5 (SW2), SW1.6 (PAD1), SW1.7 (PAD2), SW2.2 (COM), SW2.5 (SW2), SW2.6 (PAD1), SW2.7 (PAD2), U9.1 (~1OE), U9.10 (GND), U9.19 (~2OE), U10.1 (A0), U10.2 (A1), U10.3 (A2), U10.4 (GND), U10.7 (WP), U11.1 (GND), U11.5 (SDO), U11.7 (GND), U12.7 (GND), U13.3 (GND); also elsewhere on the board
LED_PWR: R12.1; also elsewhere on the board
LED_STATUS: R13.1; also elsewhere on the board
unnamed: D3.2 (A), R12.2
unnamed: D4.2 (A), R13.2
unnamed: R14.2, R17.2, SW1.1 (A)
unnamed: R15.2, R16.2, SW1.3 (B)
unnamed: R18.2, R19.1, SW1.4 (SW1)
unnamed: R22.2, R25.2, SW2.1 (A)
unnamed: R23.2, R24.2, SW2.3 (B)
unnamed: R26.2, R27.1, SW2.4 (SW1)
unnamed: R28.2, U13.2 (VOUT)
TEMP_SENSE: C72.1, R28.1; also elsewhere on the board
~ENC_1A_RAW: C30.1, R14.1, U12.3 (2A)
~ENC_1B_RAW: C31.1, R15.1, U12.5 (3A)
~ENC_1SW_RAW: C34.1, R19.2, U12.1 (1A)
~ENC_2A_RAW: C37.1, R22.1, U12.9 (4A)
~ENC_2B_RAW: C39.1, R23.1, U12.11 (5A)
~ENC_2SW_RAW: C41.1, R27.2, U12.13 (6A)

Notes on the sheet:
Encoder 2
Encoder Debouncing
Status LEDs
LM35 Temperature Sensor
SN74AHCT244 Level Shifter (3.3V to 5V)
Environmental sensor BME280
24LC256 EEPROM
J4 — FH12-10S-0.5SH (Display FPC)
Piezo Buzzer (BZ1)
Encoder 1

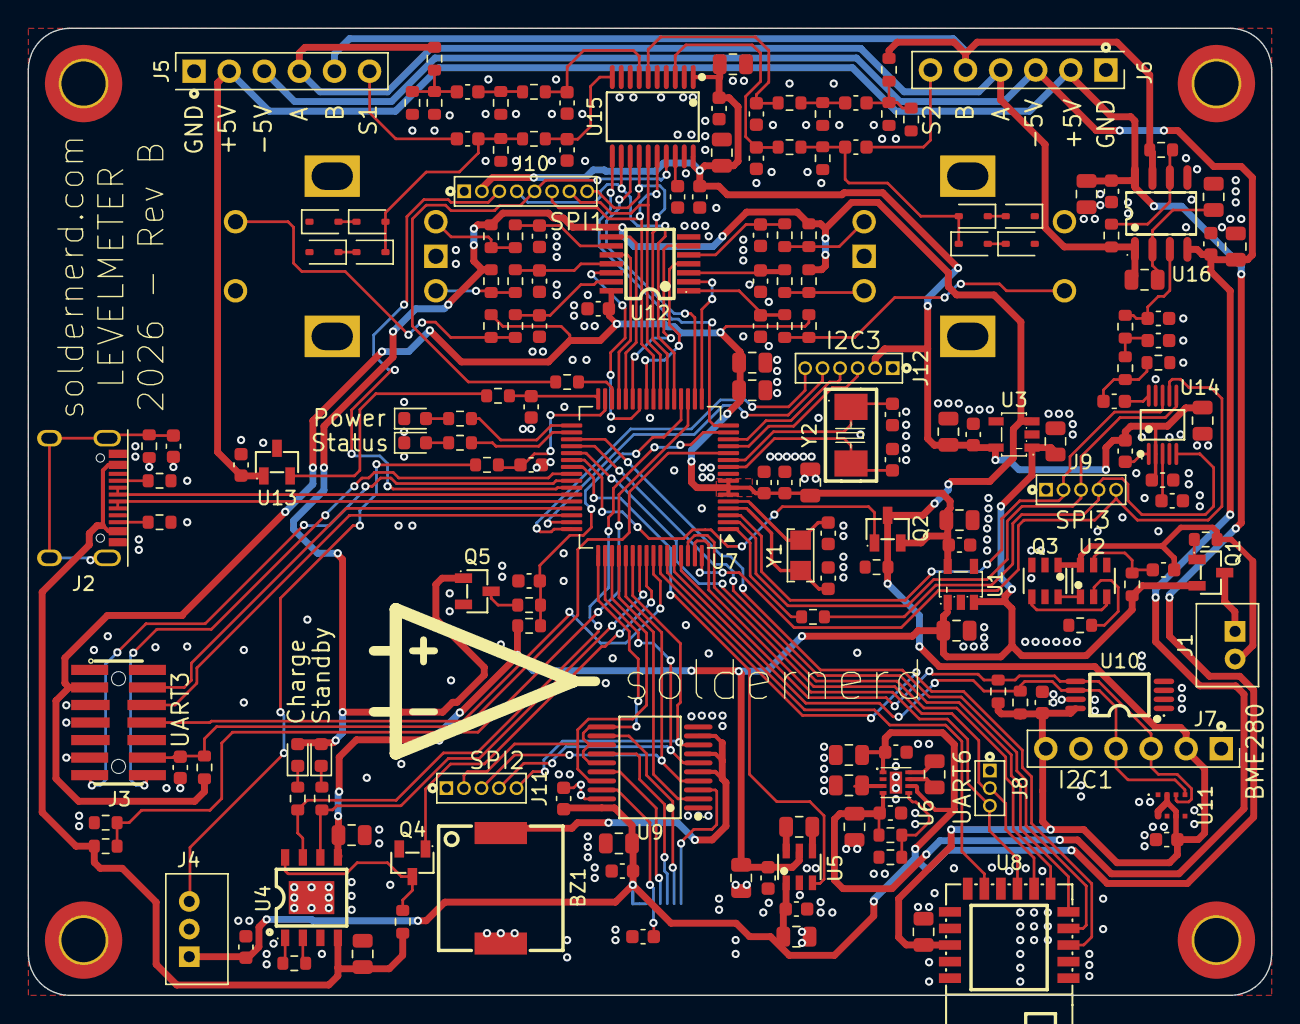
[picture p8: board Levelmeter.kicad_pcb from above]

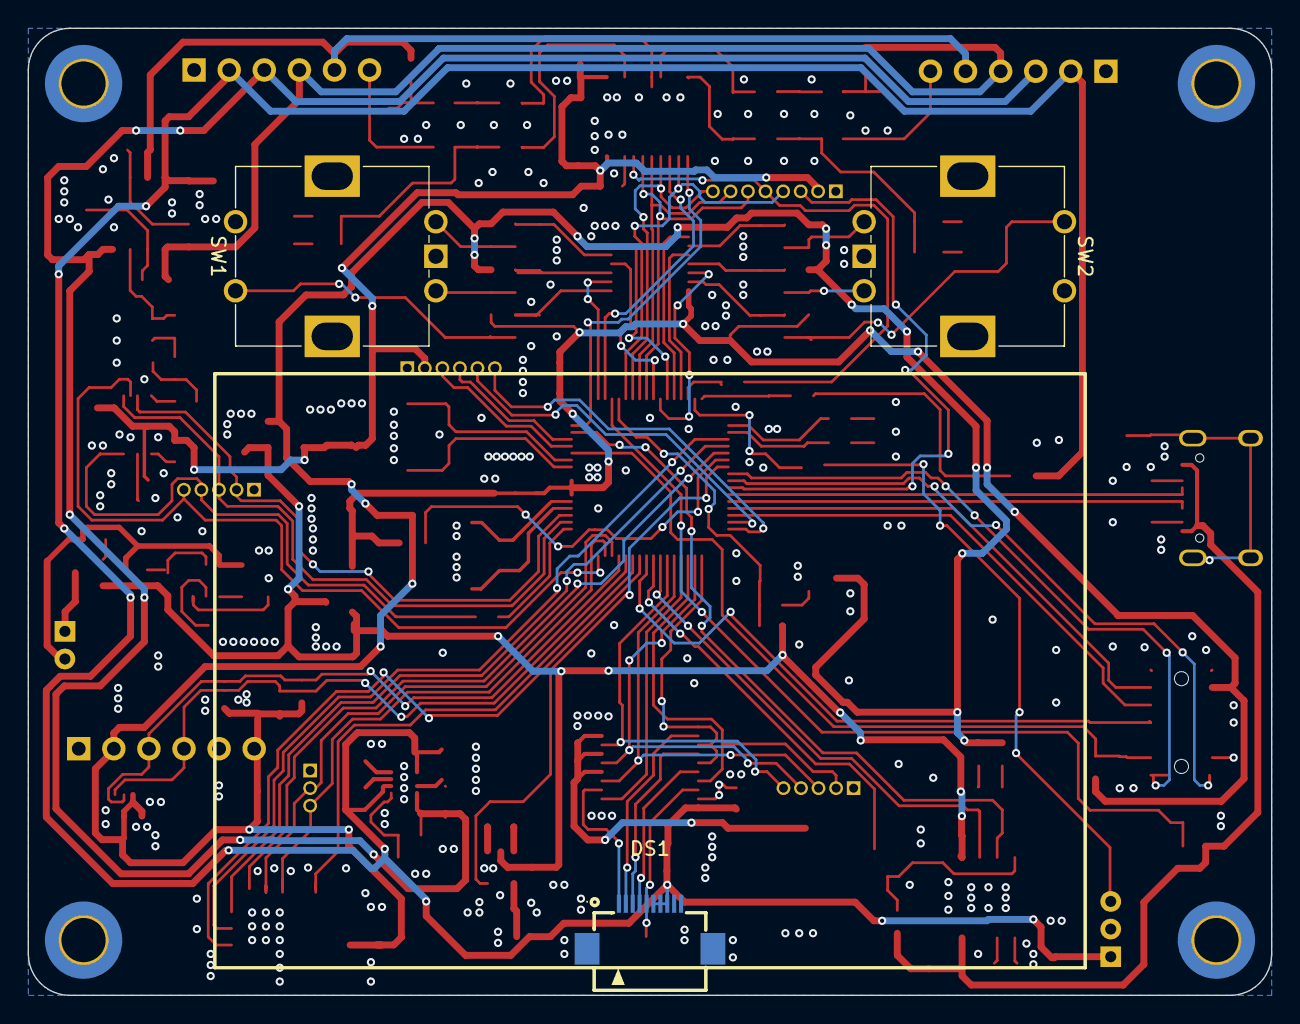
[picture p9: board Levelmeter.kicad_pcb from below]

Board: 4 copper layers, 90.0 x 70.0 mm, 188 parts (3 on the bottom side), 140 nets.
