soldernerd/LevelMeter/Leveltronic/Leveltronic.kicad_pcb

## KiCad design Leveltronic/Leveltronic.kicad_pcb (2026-08-10)

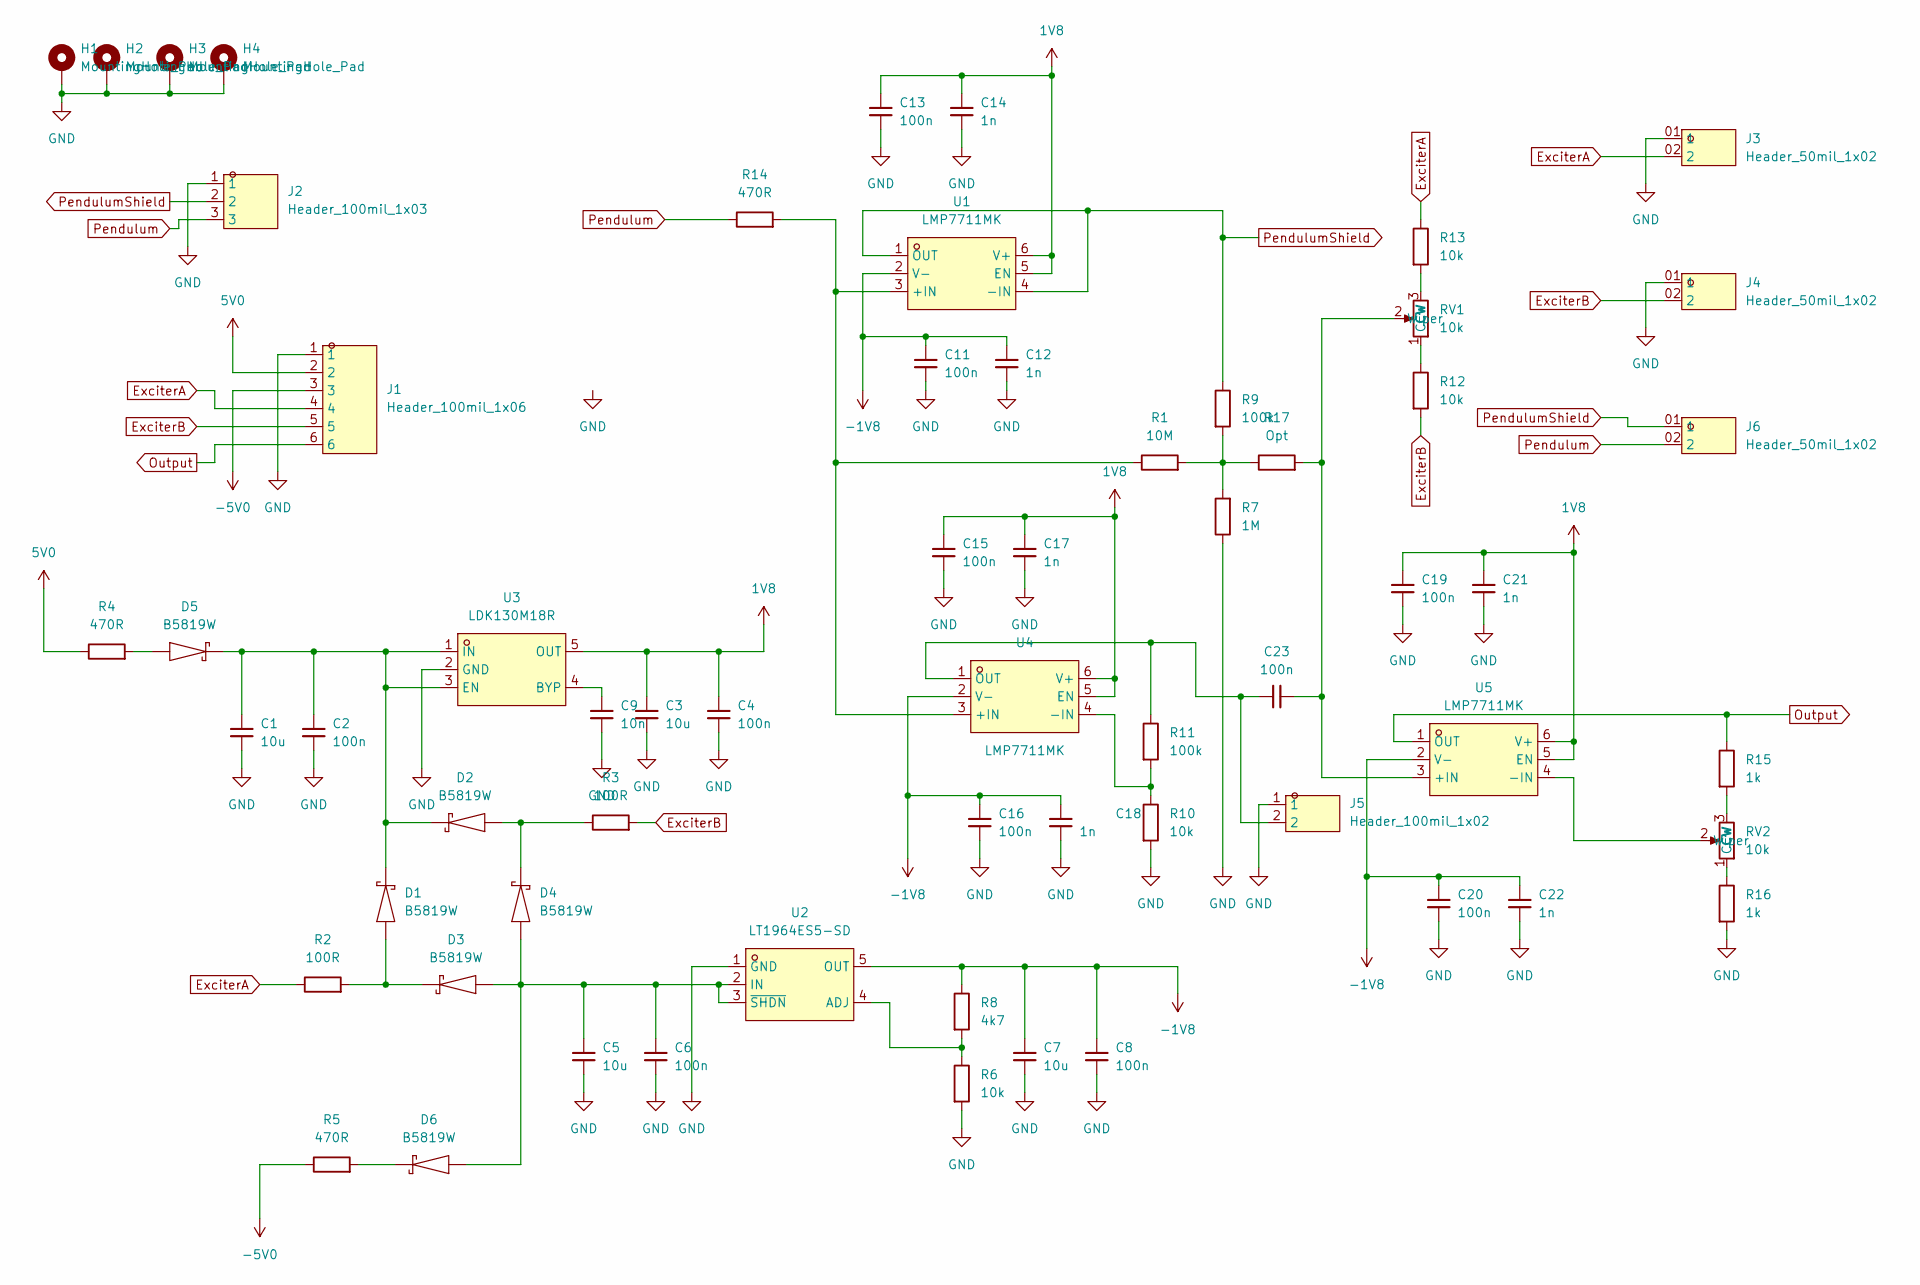
[picture p10: schematic Leveltronic.kicad_sch]

Parts:
C1, C3, C5, C7: 10u; C_1206; Voltage 25V; MPN GRM31CR71E106KA12L; LCSC C77093
C2, C4, C6, C8, C11, C13, C15, C16, C19, C20, C23: 100n; C_0805; Voltage 50V; MPN CC0805KRX7R9BB104; LCSC C49678
C9: 10n; C_0805; Voltage 50V; MPN CC0805KRX7R9BB103; LCSC C83170
C12, C14, C17, C18, C21, C22: 1n; C_0805; Voltage 50V; MPN CC0805KRX7R9BB102; LCSC C94121
D1, D2, D3, D4, D5, D6: B5819W; SOD-123; MPN B5819W; LCSC C8598
H1, H2, H3, H4: MountingHole_Pad; MountingHole_3.2mm
J1: Header_100mil_1x06; MPN A2541WV-6P; LCSC C225481
J2: Header_100mil_1x03; MPN A2541WV-3P; LCSC C225478
J3, J4: Header_50mil_1x02; MPN A2541WV-2P; LCSC C225477
J5: Header_100mil_1x02; MPN A2541WV-2P; LCSC C225477
J6: Header_50mil_1x02
R1: 10M; R_0805; MPN 0805W8F1005T5E; LCSC C325772
R2, R3: 100R; R_0805; MPN 0805W8F1000T5E; LCSC C17408
R4, R5, R14: 470R; R_0805; MPN 0805W8F4700T5E; LCSC C17710
R6, R10, R12, R13: 10k; R_0805; MPN 0805W8F1002T5E; LCSC C17414
R7: 1M; R_0805; MPN 0805W8F1004T5E; LCSC C17514
R8: 4k7; R_0805; MPN 0805W8F4701T5E; LCSC C17673
R9, R11: 100k; R_0805; MPN 0805W8F1003T5E; LCSC C149504
R15, R16: 1k; R_0805; MPN 0805W8F1001T5E; LCSC C17513
R17: Opt; R_0805; MPN 0805W8F1005T5E; LCSC C325772
RV1, RV2: 10k; Bourns_3296X; MPN 3296X
U1, U4, U5: LMP7711MK; SOT-23-6-LMP7711; MPN LMP7711MK/NOPB; LCSC C2057415
U2: LT1964ES5-SD; SOT-23-5; MPN LT1964ES5-SD#TRPBF; LCSC C461512
U3: LDK130M18R; SOT-23-5; MPN LDK130M18R; LCSC C377955

Connections:
1V8: C3.1, C4.1, C13.1, C14.1, C15.1, C17.1, C19.1, C21.1, U1.5 (EN), U1.6 (V+), U3.5 (OUT), U4.5 (EN), U4.6 (V+), U5.5 (EN), U5.6 (V+)
5V0: J1.2, R4.1
-1V8: C7.1, C8.1, C11.1, C12.1, C16.1, C18.1, C20.1, C22.1, R8.1, U1.2 (V-), U2.5 (OUT), U4.2 (V-), U5.2 (V-)
-5V0: J1.3, R5.1
ExciterA: J1.4, J3.02 (2), R2.1, R13.1
ExciterB: J1.5, J4.02 (2), R3.2, R12.2
GND: C1.2, C2.2, C3.2, C4.2, C5.2, C6.2, C7.2, C8.2, C9.2, C11.2, C12.2, C13.2, C14.2, C15.2, C16.2, C17.2, C18.2, C19.2, C20.2, C21.2, C22.2, H1.1 (1_1), H2.1 (1_1), H3.1 (1_1), H4.1 (1_1), J1.1, J2.1, J3.01 (1), J4.01 (1), J5.1, R6.2, R7.1, R10.2, R16.2, U2.1 (GND), U3.2 (GND)
unnamed: D1.2 (A), D3.1 (K), R2.2
unnamed: C1.1, C2.1, D1.1 (K), D2.1 (K), D5.1 (K), U3.1 (IN), U3.3 (EN)
unnamed: D2.2 (A), D4.1 (K), R3.1
unnamed: C5.1, C6.1, D3.2 (A), D4.2 (A), D6.2 (A), U2.2 (IN), U2.3 (~SHDN)
unnamed: D5.2 (A), R4.2
unnamed: D6.1 (K), R5.2
unnamed: R1.2, R7.2, R9.2, R17.1
unnamed: R12.1, RV1.1 (CCW)
unnamed: R13.2, RV1.3 (CW)
unnamed: C23.2, R17.2, RV1.2 (Wiper), U5.3 (+IN)
unnamed: R16.1, RV2.1 (CCW)
unnamed: R15.2, RV2.3 (CW)
unnamed: RV2.2 (Wiper), U5.4 (-IN)
unnamed: R1.1, R14.2, U1.3 (+IN), U4.3 (+IN)
unnamed: R6.1, R8.2, U2.4 (ADJ)
unnamed: C9.1, U3.4 (BYP)
unnamed: R10.1, R11.2, U4.4 (-IN)
unnamed: C23.1, J5.2, R11.1, U4.1 (OUT)
Output: J1.6, R15.1, U5.1 (OUT)
Pendulum: J2.3, J6.02 (2), R14.1
PendulumShield: J2.2, J6.01 (1), R9.1, U1.1 (OUT), U1.4 (-IN)

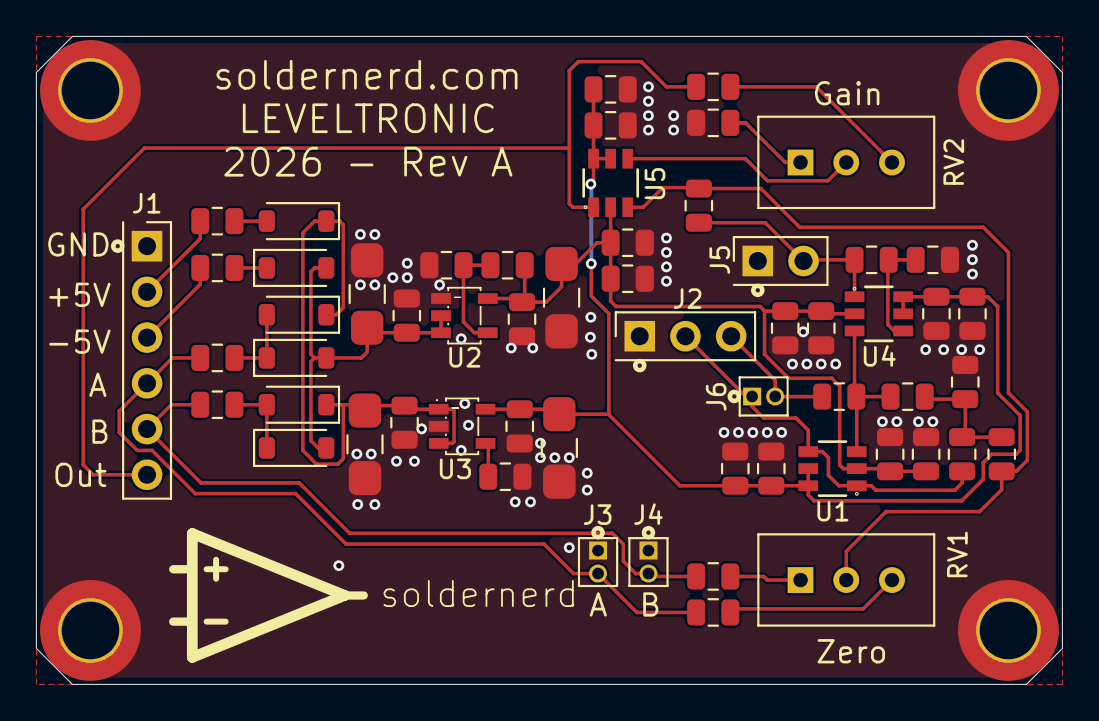
[picture p11: board Leveltronic.kicad_pcb from above]

Board: 2 copper layers, 57.0 x 36.0 mm, 62 parts (0 on the bottom side), 28 nets.
