soldernerd/LevelMeter/WylerLeveltronic.ioc

Mcu.UserName=STM32G0B1RETx
PA0.Signal=SYS_WKUP1
PA1.Signal=GPIO_Input
PA10.Signal=GPIO_Analog
PA13.Signal=SYS_SWDIO
PA14-BOOT0.Signal=SYS_SWCLK
PA15.Signal=GPIO_Analog
PA2.Signal=SYS_WKUP4
PA3.Signal=GPIO_Input
PA4.Signal=SPI1_NSS
PA5.Signal=SPI1_SCK
PA6.Signal=SPI1_MISO
PA7.Signal=SPI1_MOSI
PA8.Signal=GPIO_Input
PA9.Signal=GPIO_Input
PB0.Signal=GPXTI0
PB1.Signal=GPXTI1
PB10.Signal=S_TIM2_CH3
PB11.Signal=GPIO_Output
PB12.Signal=GPIO_Output
PB15.Signal=GPIO_Input
PB2.Signal=GPXTI2
PB4.Signal=GPIO_Input
PB5.Signal=GPIO_Output
PB6.Signal=I2C1_SCL
PB7.Signal=I2C1_SDA
PB8.Signal=USART6_TX
PB9.Signal=USART6_RX
PC10.Signal=SPI3_SCK
PC11.Signal=S_TIM1_CH4
PC12.Signal=SPI3_MOSI
PC13.Signal=GPIO_Output
PC3.Signal=GPIO_Output
PC4.Signal=GPXTI4
PC5.Signal=SYS_WKUP5
PC6.Signal=GPIO_Output
PC7.Signal=GPIO_Output
PC8.Signal=GPIO_Analog
PC9.Signal=S_TIM3_CH4
PD0.Signal=SPI2_NSS
PD1.Signal=SPI2_SCK
PD2.Signal=GPIO_Output
PD3.Signal=GPIO_Output
PD4.Signal=SPI2_MOSI
PD5.Signal=GPIO_Input
PD6.Signal=GPIO_Output
PD8.Signal=USART3_TX
PD9.Signal=USART3_RX
