soldernerd/LevelMeter/(commit log)

2026-07-29 New components added, schematic being completed
    [SignalProcessing.kicad_sch, power.kicad_sch]
2026-07-30 Schematic and component placement semi-final. Routing pending
    [Levelmeter.kicad_pcb, SignalProcessing.kicad_sch, mcu.kicad_sch]
2026-07-31 Board layout without errors
    [Levelmeter.kicad_pcb, SignalProcessing.kicad_sch, connectors.kicad_sch, mcu.kicad_sch, power.kicad_sch, ui.kicad_sch]
2026-07-31 Unavailable parts replaced, rotation issues fixed in library, except for U7
    [Levelmeter-BOM_JLCSMT.csv, Levelmeter-BOM_JLCSMT_raw.csv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]
2026-08-01 Fix stock/pinout issues, re-export fabrication files, apply JLC rotation corrections
    - Replace out-of-stock parts (D2/D3 LED, U5, U10) with in-stock JLCPCB
    alternatives; add D5-D12 protection diodes
    - Fix U2/DW01A footprint rotation on PCB
    - Re-export gerbers, drill files, and JLCSMT BOM/CPL from current design
    - BOM/CPL: DS1 uses header connector LCSC number only (display bought
    separately), U13 (LM35) and mounting holes excluded as do-not-place
    - CPL rotations for U7, U5, Q3, U2 corrected per known JLCPCB
    per-part orientation quirks (see sldrnrd_kicad_lib/JLC_ROTATION_OFFSETS.md)
    [Levelmeter-BOM_JLCSMT.csv, Levelmeter-BOM_JLCSMT_raw.csv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]
2026-08-01 Semi-final, including fabrication files
    [Levelmeter.kicad_pcb]
2026-08-01 First board version of Leveltronic. Schematic ok, layout pending
    [Leveltronic.kicad_pcb, Leveltronic.kicad_sch]
2026-08-03 Wylertronic basic board layout completed
    [Leveltronic.kicad_pcb, Leveltronic.kicad_sch]
2026-08-04 Some universality added, positive LDO replaced
    [Leveltronic-hexacore.kicad_pcb, Leveltronic.kicad_sch]
2026-08-05 Header for external BME280 module added, Keepout for BLE module fixed
    [Levelmeter.kicad_pcb, ui.kicad_sch]
2026-08-06 BLE module: footprint fixed (keepout areas), additional pins routed to MCU, 3-pin 50mil debug header added
    [Levelmeter.kicad_pcb, mcu.kicad_sch]
2026-08-07 Debug headers for SPI1, SPI2 and SPI3 added
    [Levelmeter.kicad_pcb, SignalProcessing.kicad_sch, mcu.kicad_sch, ui.kicad_sch]
2026-08-07 Leveltronic board fully layed out
    [Leveltronic-hexacore.kicad_pcb, Leveltronic.kicad_pcb, Leveltronic.kicad_sch]
2026-08-07 Levelmeter sensor pinout changed. Font changed to bold
    [Levelmeter.kicad_pcb, SignalProcessing.kicad_sch]
2026-08-08 Pinout description added, STM configuration added, netlist exported
    [Levelmeter.kicad_pcb, STM32G0B1RET6_Pinout.csv, mcu.kicad_sch, power.kicad_sch]
2026-08-08 Schematic checks, some smaller corrections, debug UART pinout corrected on programming header
    [Levelmeter.kicad_pcb, STM32G0B1RET6_Pinout.csv, connectors.kicad_sch, mcu.kicad_sch, power.kicad_sch, ui.kicad_sch]
2026-08-09 Further checks. Capacitors unified to basic parts
    [Levelmeter.kicad_pcb, STM32G0B1RET6_Pinout.csv, SignalProcessing.kicad_sch, connectors.kicad_sch, mcu.kicad_sch, power.kicad_sch, ui.kicad_sch]
2026-08-10 LEVELMETER Rev A as ordered
    [Levelmeter-BOM_JLCSMT.csv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]
2026-08-10 LEVELTRONIC Rev A as ordered
    [Leveltronic-B_Cu.gbr, Leveltronic-B_Mask.gbr, Leveltronic-B_Paste.gbr, Leveltronic-B_Silkscreen.gbr, Leveltronic-Edge_Cuts.gbr, Leveltronic-F_Cu.gbr, Leveltronic-F_Mask.gbr, Leveltronic-F_Paste.gbr]
2026-08-11 Typo in pinout fixed. Pin 64 is PC10, not PB10
    [STM32G0B1RET6_Pinout.csv]
2026-08-11 Pinout list edited
    [STM32G0B1RET6_Pinout.csv]
2026-08-12 Levelmeter REV B started
    [Levelmeter-BOM_JLCSMT.csv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]
2026-08-12 Revision B semi-final
    [Levelmeter-BOM_JLCSMT.csv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]
2026-08-13 Levelmeter Rev B as ordered
    [Levelmeter-BOM_JLCSMT.csv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]
2026-08-13 Rev B saved into separate folder to freze ordered state
    [Levelmeter-BOM_JLCSMT.csv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]
